SpaceTeam/STS1_PCB_SIDEPANEL/Muster/STS1_PCB_LIBRARIES/SpaceteamLib/spaceteam.models/Tantalum Capacitor Vishay/595D_A-case.pdf

THE INFORMATION AND/OR MATERIAL IN THIS DOCUMENT IS THE PROPERTY OF AND RESTRICTED INFORMATION AND/OR MATERIAL OF THE AUTHOR. THIS INFORMATION MAY NOT BE
USED, REPRODUCED, PUBLISHED OR DISCLOSED TO OTHERS WITHOUT WRITTEN AUTHORIZATION. IT IS TO BE USED ONLY FOR MANUFACTURING ITEMS SPECIFIED WITHIN THE DOCUMENT.
TITLE | 595D_A-case.stp PART NO | 595D_A-case REVISION | None DESIGNER | SAkselrod ENGINEER NOTES | v1.0
