SpaceTeam/STS1_PCB_SIDEPANEL/Muster/3G30A_40x80.png

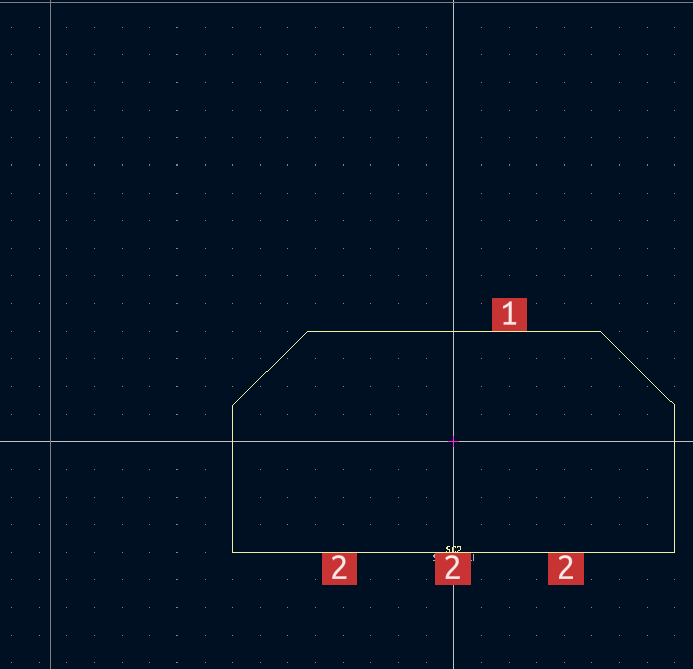
Muster/3G30A_40x80.png
