SpaceTeam/STS1_PCB_SIDEPANEL/STS1_Dhruva_Phase_2_Repaired/BOM_STS1_Sidepanels.xlsx

Sheet: X+
ID | Bezeichner | Footprint | Count | Bezeichnung
1 | RD2,RD1,RD3 | R_MiniMELF_MMA-0204 | 3 | 22R
2 | C41,C42 | C_0805_2012Metric | 2 | 22u 10V
3 | C11,C12,C61,C62 | C_0805_2012Metric | 4 | 22u 6.3V
4 | TH1 | R_0805_2012Metric_Pad1.20x1.40mm_HandSolder | 1 | Thermistor_NTC
5 | J3 | M808280442 | 1 | Conn_02x02_Odd_Even
6 | D21,D22 | DIO_SMM4F5.0A-TR | 2 | SMM4F5.0
7 | MPPT1,MPPT2 | TSSOP-8_4.4x3mm_P0.65mm | 2 | SPV1040TTR
8 | R21,R22,R31,R32,R41,R42,R71,R72 | R_0603_1608Metric | 8 | 1k
9 | D11,D12 | D_SOD-123F | 2 | PMEG2020EH
10 | R61,R62 | R_0603_1608Metric | 2 | 3k
11 | R11,R12 | R_0805_2012Metric | 2 | 10m
12 | U11,U12 | SOT-23-5 | 2 | INA180A4
13 | R51,R52 | R_0805_2012Metric | 2 | 220m
14 | C21,C22,C31,C32 | C_0603_1608Metric | 4 | 1n
15 | C51,C52 | C_0603_1608Metric | 2 | 1u
16 | J1 | SAMTEC_ZF5S-08-01-T-WT | 1 | Conn_01x10
17 | L_IN2,L1 | IND_XAL6060-103MEC | 2 | 10u

Sheet: Y-
ID | Bezeichner | Footprint | Count | Bezeichnung
1 | U1 | OLGA | 1 | GUVA-C32SM
2 | J1 | SAMTEC_ZF5S-08-01-T-WT | 1 | Conn_01x08
3 | C21,C22,C31,C32 | C_0603_1608Metric | 4 | 1n
4 | L1,L2 | IND_XAL6060-103MEC | 2 | 10u
5 | C41,C42 | C_0805_2012Metric | 2 | 22u 10V
6 | C11,C12,C61,C62 | C_0805_2012Metric | 4 | 22u 6.3V
7 | RU1,RU2 | R_0603_1608Metric | 2 | 4k7
8 | D11,D12 | D_SOD-123F | 2 | PMEG2020EH
9 | MPPT1,MPPT2 | TSSOP-8_4.4x3mm_P0.65mm | 2 | SPV1040TTR
10 | UV1 | 200528-0040 | 1 | 501461-0491
11 | R61,R62 | R_0603_1608Metric | 2 | 3k
12 | R21,R22,R31,R32,R41,R42,R71,R72 | R_0603_1608Metric | 8 | 1k
13 | D21,D22 | DIO_SMM4F5.0A-TR | 2 | SMM4F5.0
14 | U11,U12 | SOT-23-5 | 2 | INA180A4
15 | C1,C51,C52 | C_0603_1608Metric | 3 | 1u
16 | R11,R12 | R_0805_2012Metric | 2 | 10m
17 | R51,R52 | R_0805_2012Metric | 2 | 220m
18 | TH1 | R_0805_2012Metric_Pad1.20x1.40mm_HandSolder | 1 | Thermistor_NTC
19 | IC1 | SOT-563 | 1 | TMP112AQDRLRQ1

Sheet: Y+
ID | Bezeichner | Footprint | Count | Bezeichnung
1 | U1 | OLGA | 1 | GUVA-C32SM
2 | J1 | SAMTEC_ZF5S-08-01-T-WT | 1 | Conn_01x08
3 | C21,C22,C31,C32 | C_0603_1608Metric | 4 | 1n
4 | L1,L2 | IND_XAL6060-103MEC | 2 | 10u
5 | C41,C42 | C_0805_2012Metric | 2 | 22u 10V
6 | C11,C12,C61,C62 | C_0805_2012Metric | 4 | 22u 6.3V
6 | RU1,RU2 | R_0603_1608Metric | 2 | 4k7
7 | D11,D12 | D_SOD-123F | 2 | PMEG2020EH
8 | MPPT1,MPPT2 | TSSOP-8_4.4x3mm_P0.65mm | 2 | SPV1040TTR
9 | UV1 | 200528-0040 | 1 | 501461-0491
10 | R61,R62 | R_0603_1608Metric | 2 | 3k
11 | R21,R22,R31,R32,R41,R42,R71,R72 | R_0603_1608Metric | 8 | 1k
12 | D21,D22 | DIO_SMM4F5.0A-TR | 2 | SMM4F5.0
13 | U11,U12 | SOT-23-5 | 2 | INA180A4
14 | C1,C51,C52 | C_0603_1608Metric | 3 | 1u
15 | R11,R12 | R_0805_2012Metric | 2 | 10m
16 | R51,R52 | R_0805_2012Metric | 2 | 220m
17 | TH1 | R_0805_2012Metric_Pad1.20x1.40mm_HandSolder | 1 | Thermistor_NTC
18 | IC1 | SOT-563 | 1 | TMP112AQDRLRQ1

Sheet: Z-
ID | Bezeichner | Footprint | Count | Bezeichnung
1 | U1 | OLGA | 1 | GUVA-C32SM
2 | edu_con1,cam1 | 545482271 | 2 | 54548-2271
3 | R21,R31,R41,R71 | R_0603_1608Metric | 4 | 1k
4 | TH1 | R_0805_2012Metric_Pad1.20x1.40mm_HandSolder | 1 | Thermistor_NTC
5 | UV1 | 200528-0040 | 1 | 501461-0491
6 | C1,C51 | C_0603_1608Metric | 2 | 1u
7 | IC1 | SOT-563 | 1 | TMP112AQDRLRQ1
8 | C41 | C_0805_2012Metric | 1 | 22u 10V
9 | C11,C61 | C_0805_2012Metric | 2 | 22u 6.3V
10 | RU1,RU2 | R_0603_1608Metric | 2 | 4k7
11 | D21 | DIO_SMM4F5.0A-TR | 1 | SMM4F5.0
12 | L1 | IND_XAL6060-103MEC | 1 | 10u
13 | J1 | SAMTEC_ZF5S-16-01-T-WT | 1 | Conn_01x18
14 | U11 | SOT-23-5 | 1 | INA180A4
15 | R61 | R_0603_1608Metric | 1 | 3k
16 | C21,C31 | C_0603_1608Metric | 2 | 1n
17 | MPPT1 | TSSOP-8_4.4x3mm_P0.65mm | 1 | SPV1040TTR
18 | R51 | R_0805_2012Metric | 1 | 220m
19 | D11 | D_SOD-123F | 1 | PMEG2020EH
20 | R11 | R_0805_2012Metric | 1 | 10m

Sheet: Z+
ID | Bezeichner | Footprint | Count | Bezeichnung
1 | U1 | OLGA | 1 | GUVA-C32SM
2 | C1,C51 | C_0603_1608Metric | 2 | 1u
3 | IC1 | SOT-563 | 1 | TMP112AQDRLRQ1
4 | C21,C31 | C_0603_1608Metric | 2 | 1n
5 | MPPT1 | TSSOP-8_4.4x3mm_P0.65mm | 1 | SPV1040TTR
6 | D21 | DIO_SMM4F5.0A-TR | 1 | SMM4F5.0
7 | R51 | R_0805_2012Metric | 1 | 220m
8 | R61 | R_0603_1608Metric | 1 | 3k
9 | R21,R31,R41,R71 | R_0603_1608Metric | 4 | 1k
10 | L1 | IND_XAL6060-103MEC | 1 | 10u
11 | RU1,RU2 | R_0603_1608Metric | 2 | 4k7
12 | R11 | R_0805_2012Metric | 1 | 10m
13 | J1 | SAMTEC_ZF5S-08-01-T-WT | 1 | Conn_01x08
14 | edu_con2,cam2 | 545482271 | 2 | 54548-2271
15 | UV1 | 200528-0040 | 1 | 501461-0491
16 | C41 | C_0805_2012Metric | 1 | 22u 10V
17 | C11,C61 | C_0805_2012Metric | 2 | 22u 6.3V
18 | TH1 | R_0805_2012Metric_Pad1.20x1.40mm_HandSolder | 1 | Thermistor_NTC
19 | U11 | SOT-23-5 | 1 | INA180A4
20 | D11 | D_SOD-123F | 1 | PMEG2020EH
