SpaceTeam/STS1_PCB_SIDEPANEL/Muster/STS1_PCB_LIBRARIES/Parts/小功率封装.dxf

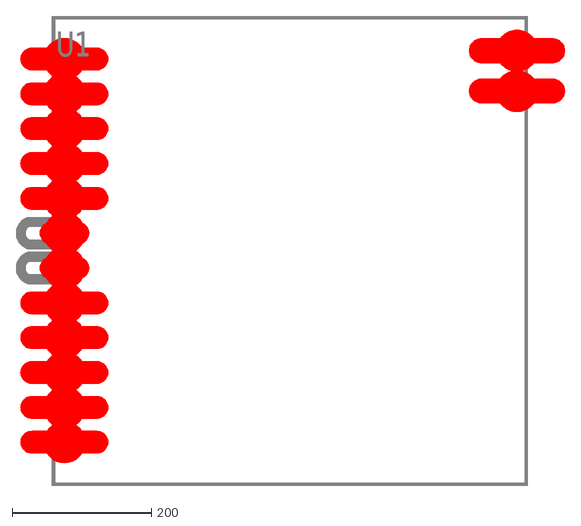
[picture p2: CAD file, 2022-07-06]
Muster/STS1_PCB_LIBRARIES/Parts/小功率封装.dxf
U1
