SpaceTeam/STS1_PCB_SIDEPANEL/Muster/STS1_PCB_LIBRARIES/SpaceteamLib/spaceteam.models/Tantalum Capacitor Vishay/595D_R-case.stp

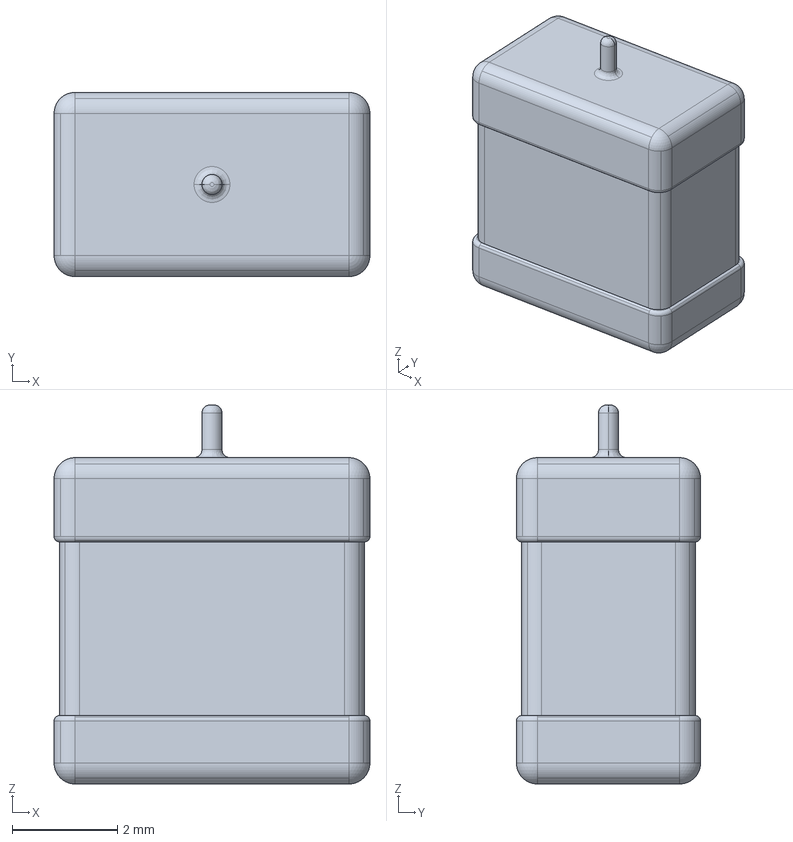
[picture p4: CAD file, 2022-07-06]
Muster/STS1_PCB_LIBRARIES/SpaceteamLib/spaceteam.models/Tantalum Capacitor Vishay/595D_R-case.stp
6.00 x 3.50 x 7.20 mm
