SpaceTeam/STS1_PCB_SIDEPANEL/Muster/STS1_PCB_LIBRARIES/SpaceteamLib/spaceteam.models/Wuerth_Inductor/WE-HCI_1335_744313 (rev1).stp

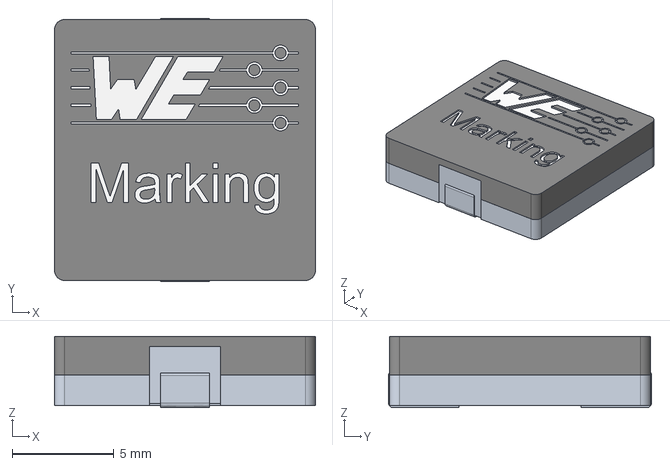
[picture p5: CAD file, 2022-07-06]
Muster/STS1_PCB_LIBRARIES/SpaceteamLib/spaceteam.models/Wuerth_Inductor/WE-HCI_1335_744313 (rev1).stp
12.8 x 12.9 x 3.50 mm
