SpaceTeam/STS1_PCB_SIDEPANEL/Muster/STS1_PCB_LIBRARIES/SpaceteamLib/spaceteam.models/Tantalum Capacitor Vishay/R-Case.FCStd

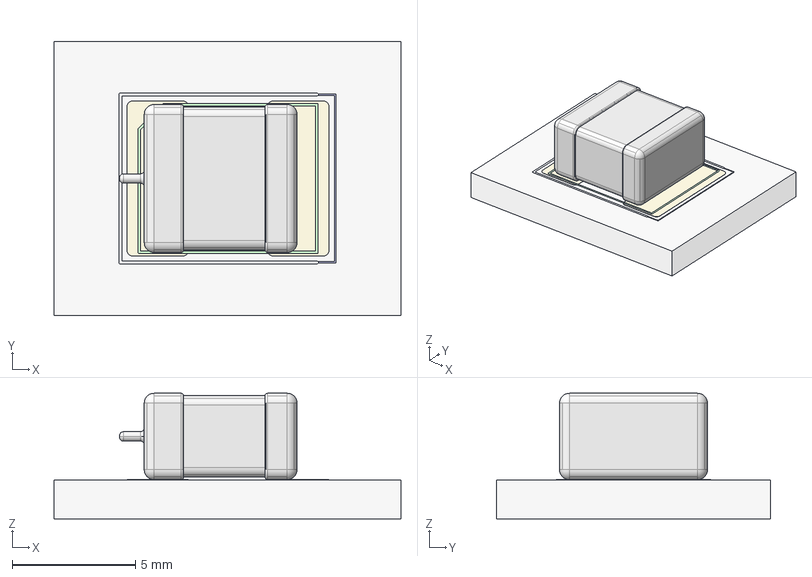
[picture p7: CAD file, 2022-07-06]
Muster/STS1_PCB_LIBRARIES/SpaceteamLib/spaceteam.models/Tantalum Capacitor Vishay/R-Case.FCStd
14.1 x 11.1 x 5.09 mm
FCrtYd
FFab
FrontSilk
TopPads
Pcb
595D_R-CASE
