SpaceTeam/STS1_PCB_SIDEPANEL/Muster/STS1_PCB_LIBRARIES/SpaceteamLib/spaceteam.models/Tantalum Capacitor Vishay/595D_D-case.stp

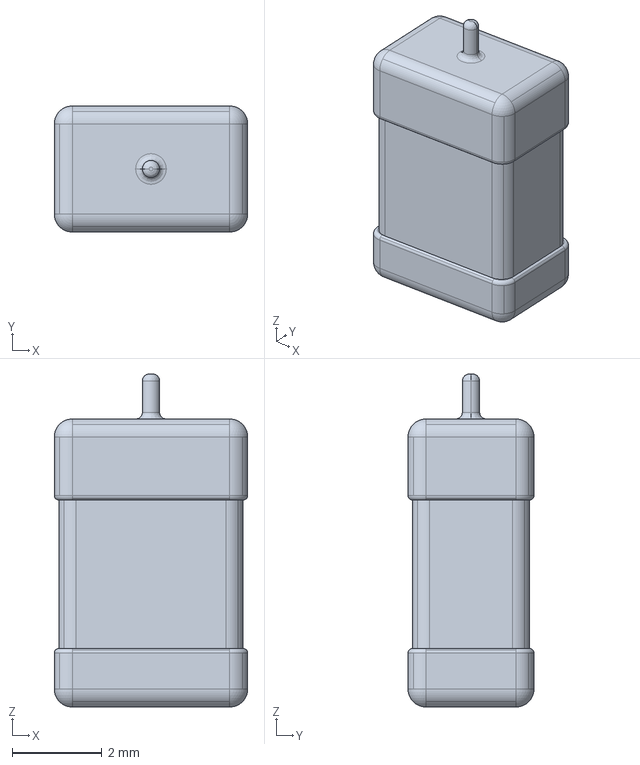
[picture p9: CAD file, 2022-07-06]
Muster/STS1_PCB_LIBRARIES/SpaceteamLib/spaceteam.models/Tantalum Capacitor Vishay/595D_D-case.stp
4.30 x 2.80 x 7.40 mm
