SpaceTeam/STS1_PCB_SIDEPANEL/Muster/STS1_PCB_LIBRARIES/SpaceteamLib/spaceteam.models/DG308-2.54-xxP (pitch 2.54mm)/DG308-2.54-06P-14-00AH.STEP

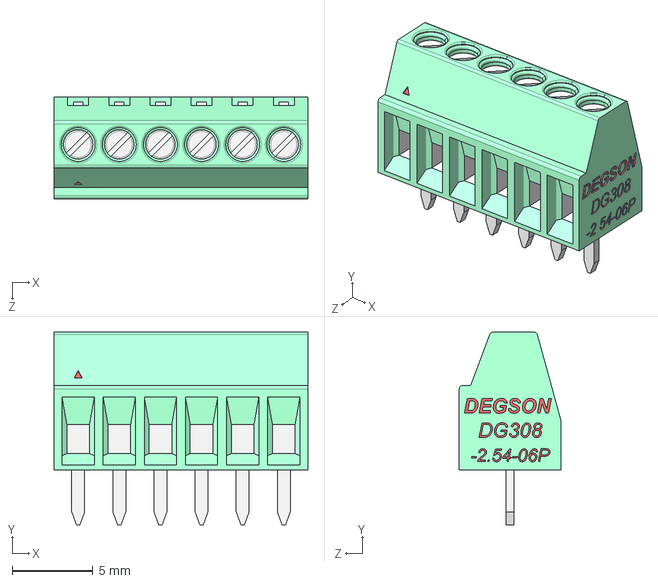
[picture p10: CAD file, 2022-07-06]
Muster/STS1_PCB_LIBRARIES/SpaceteamLib/spaceteam.models/DG308-2.54-xxP (pitch 2.54mm)/DG308-2.54-06P-14-00AH.STEP
15.7 x 11.9 x 6.27 mm
