SpaceTeam/STS1_PCB_SIDEPANEL/Muster/STS1_PCB_LIBRARIES/SpaceteamLib/spaceteam.models/Tantalum Capacitor Vishay/595D_C-case.stp

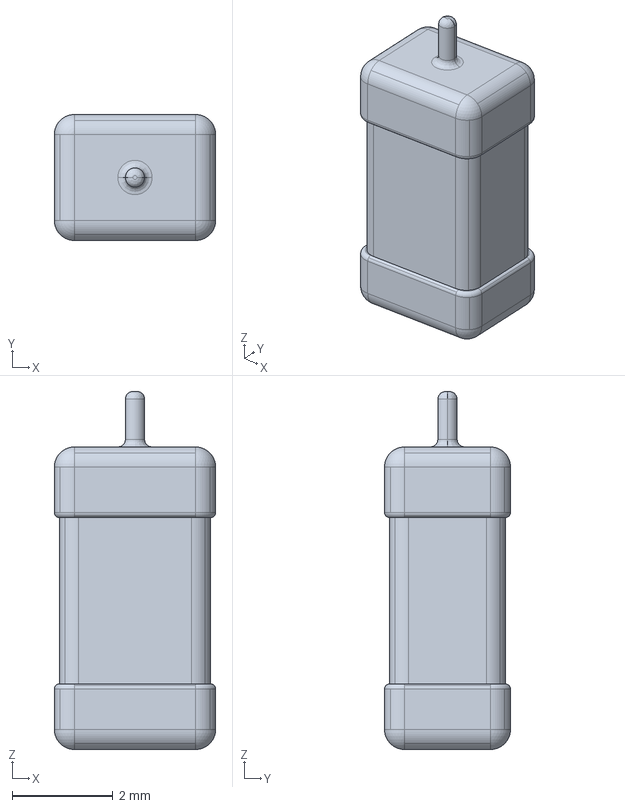
[picture p11: CAD file, 2022-07-06]
Muster/STS1_PCB_LIBRARIES/SpaceteamLib/spaceteam.models/Tantalum Capacitor Vishay/595D_C-case.stp
3.20 x 2.50 x 7.10 mm
