SpaceTeam/STS1_PCB_SIDEPANEL/Muster/STS1_PCB_LIBRARIES/Parts/F27 F30  package 2018.dxf

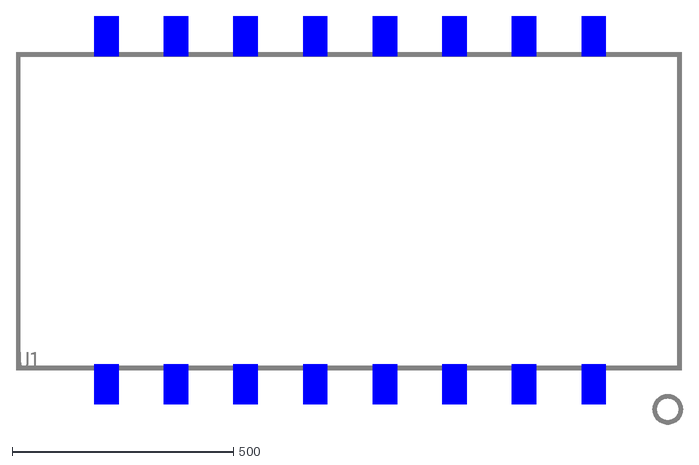
[picture p12: CAD file, 2022-07-06]
Muster/STS1_PCB_LIBRARIES/Parts/F27 F30 package 2018.dxf
U1
