SpaceTeam/STS1_PCB_SIDEPANEL/(list of files, cad)

Other CAD files:
Muster/STS1_PCB_LIBRARIES/Parts/si4463_Vc2/master/master.obj
Muster/STS1_PCB_LIBRARIES/Parts/si4463_Vc2/slaver/startup.obj
Muster/STS1_PCB_LIBRARIES/Parts/si4463_Vc2/master/startup.obj
Muster/STS1_PCB_LIBRARIES/Parts/si4463_Vc2/slaver/slaver.obj
Muster/STS1_PCB_LIBRARIES/SpaceteamLib/spaceteam.models/Tantalum Capacitor Vishay/595D_R-case-corrected.stp
Muster/STS1_PCB_LIBRARIES/Parts/si4463_Vc2/master/master(1).obj
Muster/STS1_PCB_LIBRARIES/Parts/si4463_Vc2/master/startup(1).obj
Muster/STS1_PCB_LIBRARIES/Parts/si4463_Vc2/slaver/slaver(1).obj
Muster/STS1_PCB_LIBRARIES/Parts/si4463_Vc2/slaver/startup(1).obj
Muster/STS1_PCB_LIBRARIES/SpaceteamLib/spaceteam.models/MAX16990ATCE_V_.step
Muster/STS1_PCB_LIBRARIES/SpaceteamLib/spaceteam.models/Maxim_Electronics_-_MAX25239AFOA/MAX25239_MAX25240.step
