SpaceTeam/STS1_PCB_SIDEPANEL/(threads)

Thread 20 (2024-05-06):

Remove Ground loops

dergaliator, 2024-05-06:
EDU Flex PCB Connectors and EPS Flex PCB Connector generate a ground loop.

Closed 2024-08-11.
