SpaceTeam/STS1_PCB_SIDEPANEL/(list of files, drawings)

Other design files:
Muster/STS1_PCB_LIBRARIES/Parts/F27 F30 package 2018(1).pcb
Muster/STS1_PCB_LIBRARIES/Parts/F27 F30 package 2018(2).pcb
Muster/STS1_PCB_LIBRARIES/Parts/F27 F30 package 2018(3).pcb
Muster/STS1_PCB_LIBRARIES/Parts/F27 F30 package 2018.pcb
