SpaceTeam/STS1_PCB_SIDEPANEL/Sidepanel X+/STS1_SIDEPANEL.kicad_pcb

## KiCad design Sidepanel X+/STS1_SIDEPANEL.kicad_pcb (2026-10-17)

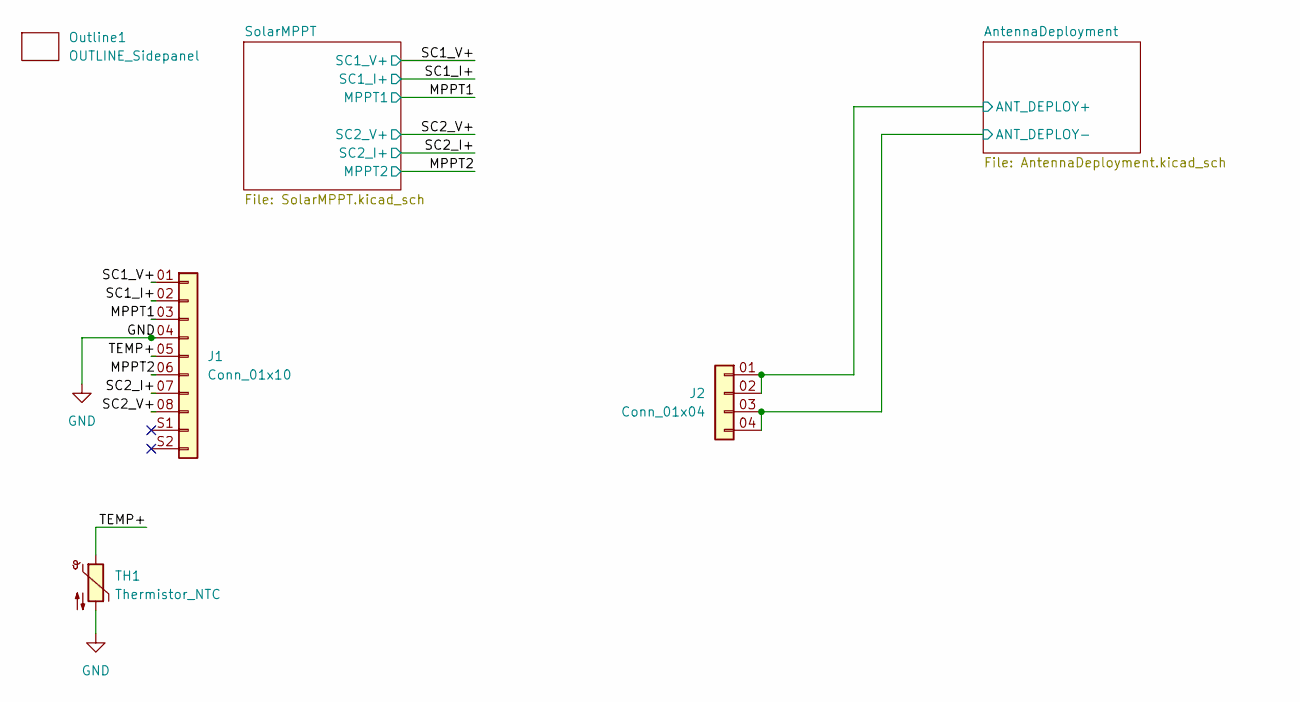
[picture p22: schematic STS1_SIDEPANEL.kicad_sch]

Parts:
J1: Conn_01x10; SAMTEC_T1M-08-F-SH-L
J2: Conn_01x04; SAMTEC_T1M-04-X-SV-L
Outline1: OUTLINE_Sidepanel; OUTLINE_SidepanelX+
TH1: Thermistor_NTC; R_0805_2012Metric_Pad1.20x1.40mm_HandSolder

Connections:
/AntennaDeployment/ANT_DEPLOY+: J2.01 (Pin_1), J2.02 (Pin_2); also elsewhere on the board
/AntennaDeployment/ANT_DEPLOY-: J2.03 (Pin_3), J2.04 (Pin_4); also elsewhere on the board
/MPPT1: J1.03 (Pin_3); also elsewhere on the board
/MPPT2: J1.06 (Pin_6); also elsewhere on the board
/SC1_I+: J1.02 (Pin_2); also elsewhere on the board
/SC1_V+: J1.01 (Pin_1); also elsewhere on the board
/SC2_I+: J1.07 (Pin_7); also elsewhere on the board
/SC2_V+: J1.08 (Pin_8); also elsewhere on the board
/TEMP+: J1.05 (Pin_5), TH1.1
GND: J1.04 (Pin_4), TH1.2; also elsewhere on the board

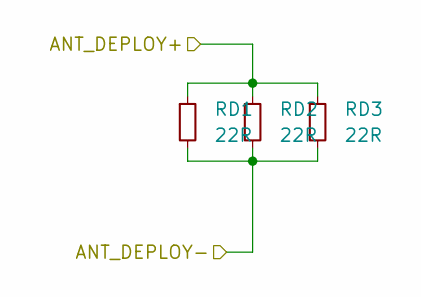
[picture p23: schematic AntennaDeployment.kicad_sch]

Parts:
RD1, RD2, RD3: 22R; R_MiniMELF_MMA-0204

Connections:
/AntennaDeployment/ANT_DEPLOY+: RD1.1, RD2.1, RD3.1; also elsewhere on the board
/AntennaDeployment/ANT_DEPLOY-: RD1.2, RD2.2, RD3.2; also elsewhere on the board

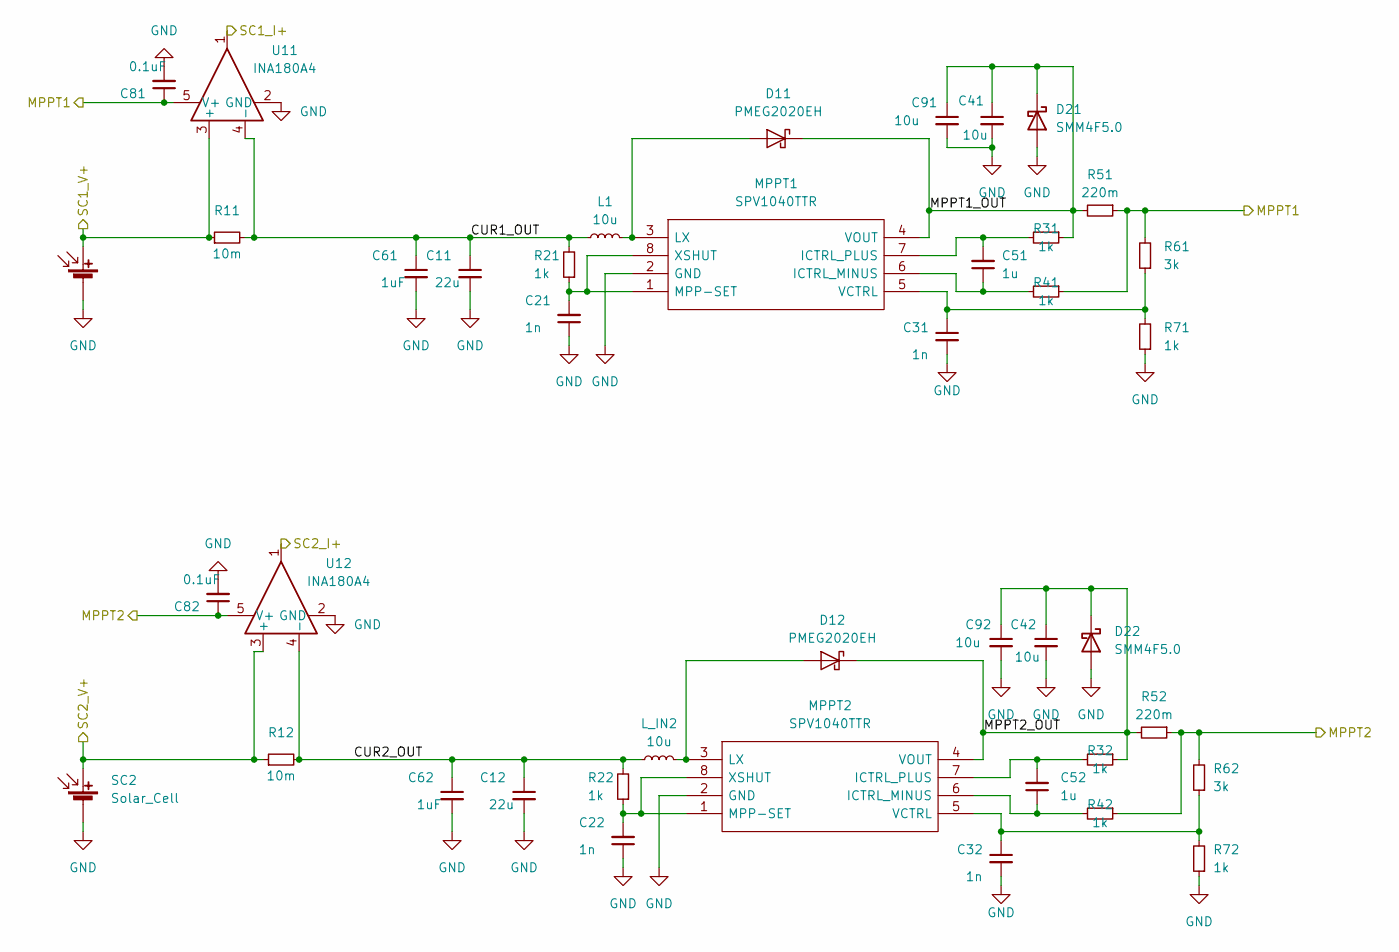
[picture p24: schematic SolarMPPT.kicad_sch]

Parts:
C11, C12: 22u; C_0805_2012Metric
C21, C22, C31, C32: 1n; C_0603_1608Metric
C41, C42, C91, C92: 10u; C_0805_2012Metric
C51, C52: 1u; C_0603_1608Metric
C61, C62: 1uF; C_0805_2012Metric
C81, C82: 0.1uF; C_0603_1608Metric
D11, D12: PMEG2020EH; D_SOD-123F
D21, D22: SMM4F5.0; DIO_SMM4F5.0A-TR
L1: 10u; IND_XAL6060-103MEC
L_IN2: 10u; IND_XAL6060-103MEC
MPPT1, MPPT2: SPV1040TTR; TSSOP-8_4.4x3mm_P0.65mm; Mouser Part Number 511-SPV1040TTR
R11, R12: 10m; R_0805_2012Metric
R21, R22, R31, R32, R41, R42, R71, R72: 1k; R_0603_1608Metric
R51, R52: 220m; R_0805_2012Metric
R61, R62: 3k; R_0603_1608Metric
SC1: Solar_Cell; 3G30A_40x80_Z_SC1
SC2: Solar_Cell; 3G30A_40x80_Z_SC2
U11, U12: INA180A4; SOT-23-5

Connections:
/MPPT1: C81.1, R41.1, R51.1, R61.2, U11.5 (V+); also elsewhere on the board
/MPPT2: C82.1, R42.1, R52.1, R62.2, U12.5 (V+); also elsewhere on the board
/SC1_I+: U11.1; also elsewhere on the board
/SC1_V+: R11.1, SC1.1 (+), U11.3 (+); also elsewhere on the board
/SC2_I+: U12.1; also elsewhere on the board
/SC2_V+: R12.1, SC2.1 (+), U12.3 (+); also elsewhere on the board
/SolarMPPT/CUR1_OUT: C11.1, C61.1, L1.1, R11.2, R21.2, U11.4 (-)
/SolarMPPT/CUR2_OUT: C12.1, C62.1, L_IN2.1, R12.2, R22.2, U12.4 (-)
/SolarMPPT/MPPT1_OUT: C41.1, C91.1, D11.1 (K), D21.1 (K), MPPT1.4 (VOUT), R31.1, R51.2
/SolarMPPT/MPPT2_OUT: C42.1, C92.1, D12.1 (K), D22.1 (K), MPPT2.4 (VOUT), R32.1, R52.2
GND: C11.2, C12.2, C21.1, C22.1, C31.2, C32.2, C41.2, C42.2, C61.2, C62.2, C81.2, C82.2, C91.2, C92.2, D21.2 (A), D22.2 (A), MPPT1.2 (GND), MPPT2.2 (GND), R71.1, R72.1, SC1.2 (-), SC2.2 (-), U11.2 (GND), U12.2 (GND); also elsewhere on the board
unnamed: D11.2 (A), L1.2, MPPT1.3 (LX)
unnamed: D12.2 (A), L_IN2.2, MPPT2.3 (LX)
unnamed: C51.1, MPPT1.6 (ICTRL_MINUS), R41.2
unnamed: C51.2, MPPT1.7 (ICTRL_PLUS), R31.2
unnamed: C21.2, MPPT1.1 (MPP-SET), MPPT1.8 (XSHUT), R21.1
unnamed: C31.1, MPPT1.5 (VCTRL), R61.1, R71.2
unnamed: C52.1, MPPT2.6 (ICTRL_MINUS), R42.2
unnamed: C52.2, MPPT2.7 (ICTRL_PLUS), R32.2
unnamed: C22.2, MPPT2.1 (MPP-SET), MPPT2.8 (XSHUT), R22.1
unnamed: C32.1, MPPT2.5 (VCTRL), R62.1, R72.2

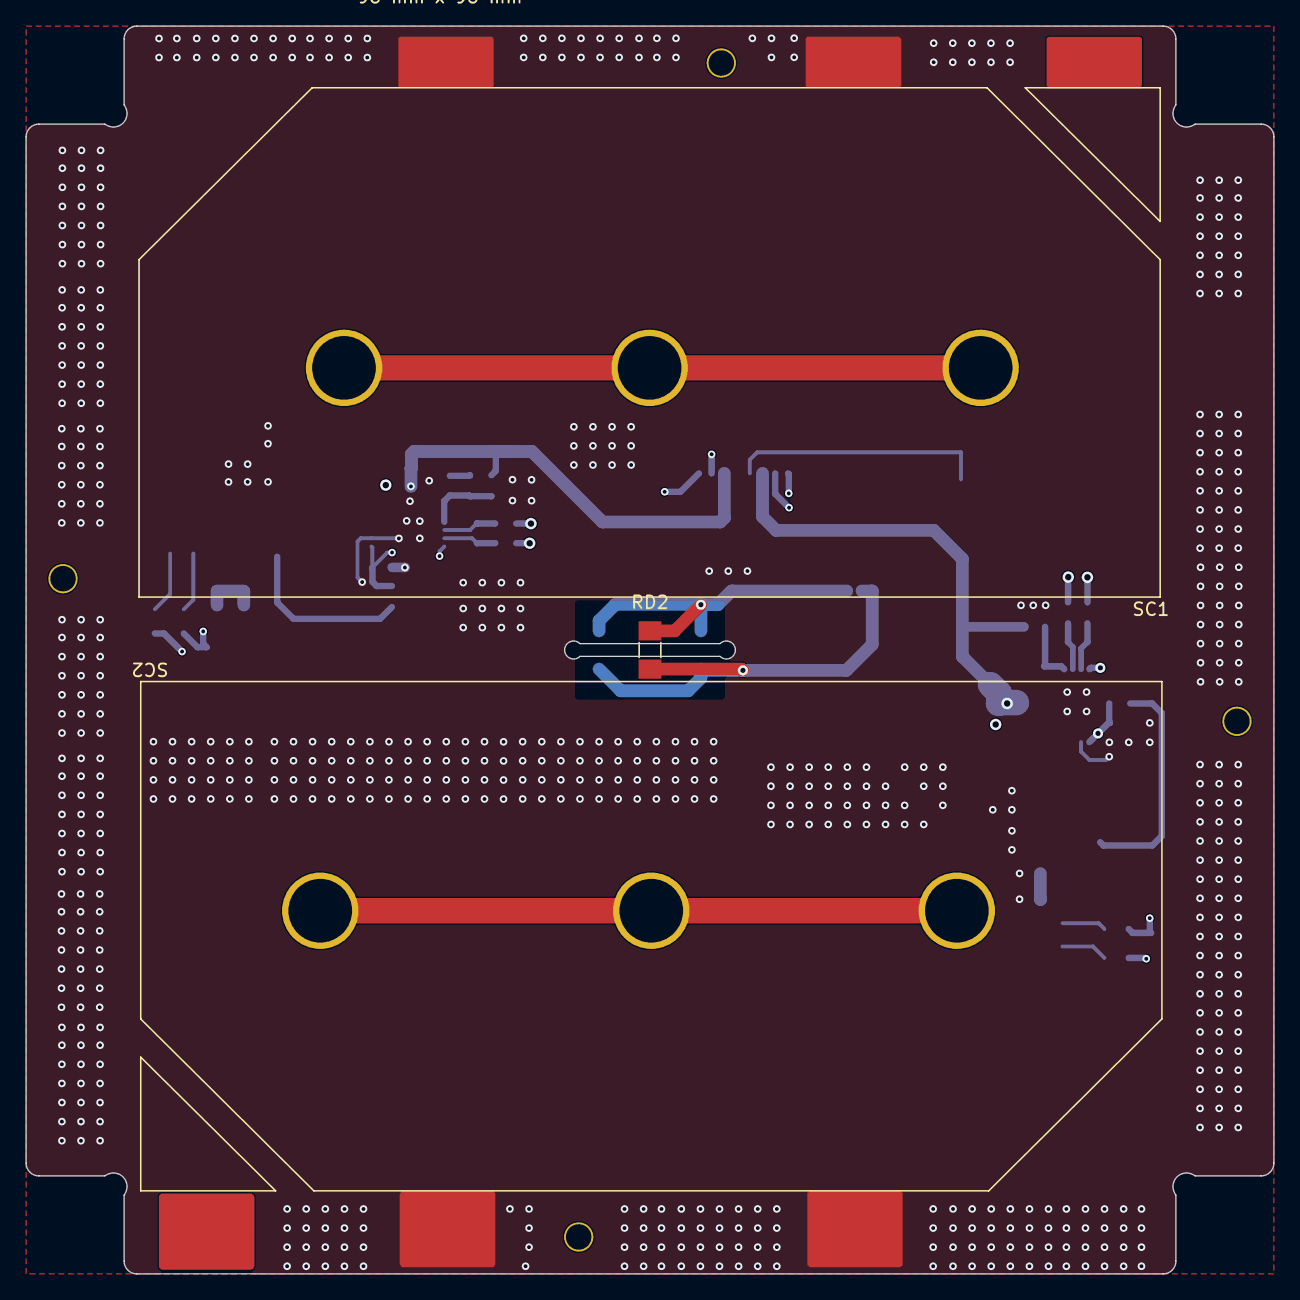
[picture p25: board Sidepanel X+/STS1_SIDEPANEL.kicad_pcb from above]

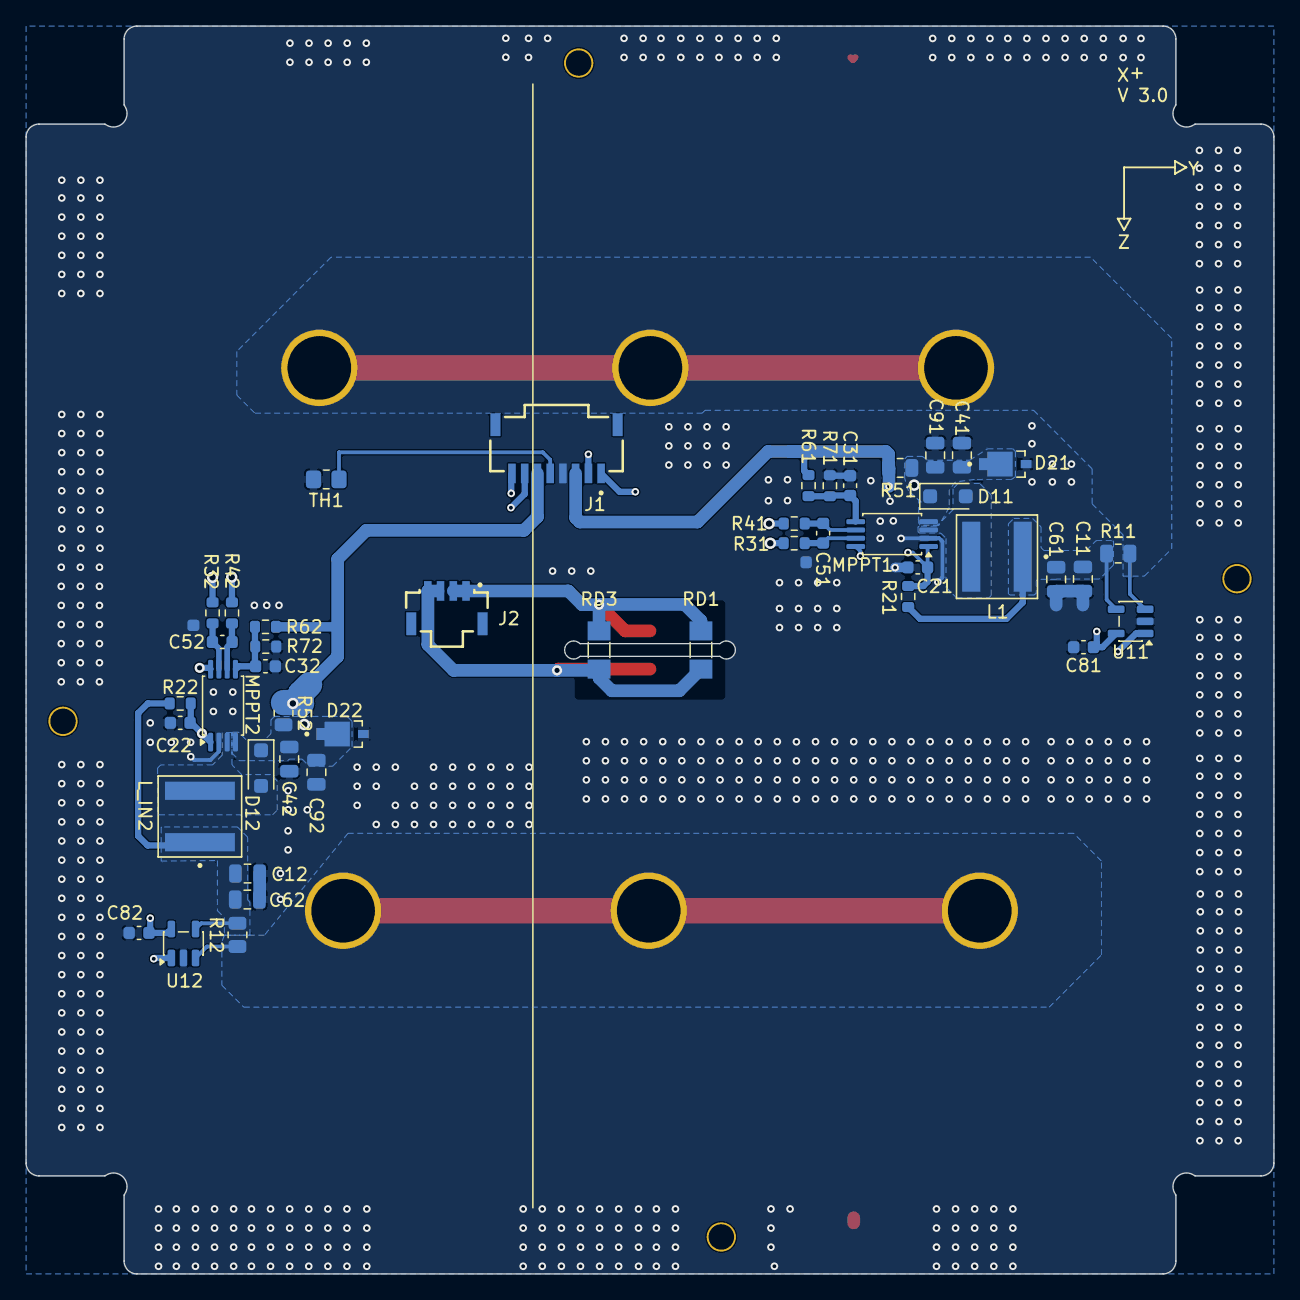
[picture p26: board Sidepanel X+/STS1_SIDEPANEL.kicad_pcb from below]

Board: 4 copper layers, 98.0 x 98.0 mm, 49 parts (45 on the bottom side), 24 nets.
