SpaceTeam/STS1_PCB_SIDEPANEL/Sidepanel Z-/STS1_SIDEPANEL.kicad_pcb

## KiCad design Sidepanel Z-/STS1_SIDEPANEL.kicad_pcb (2026-07-31)

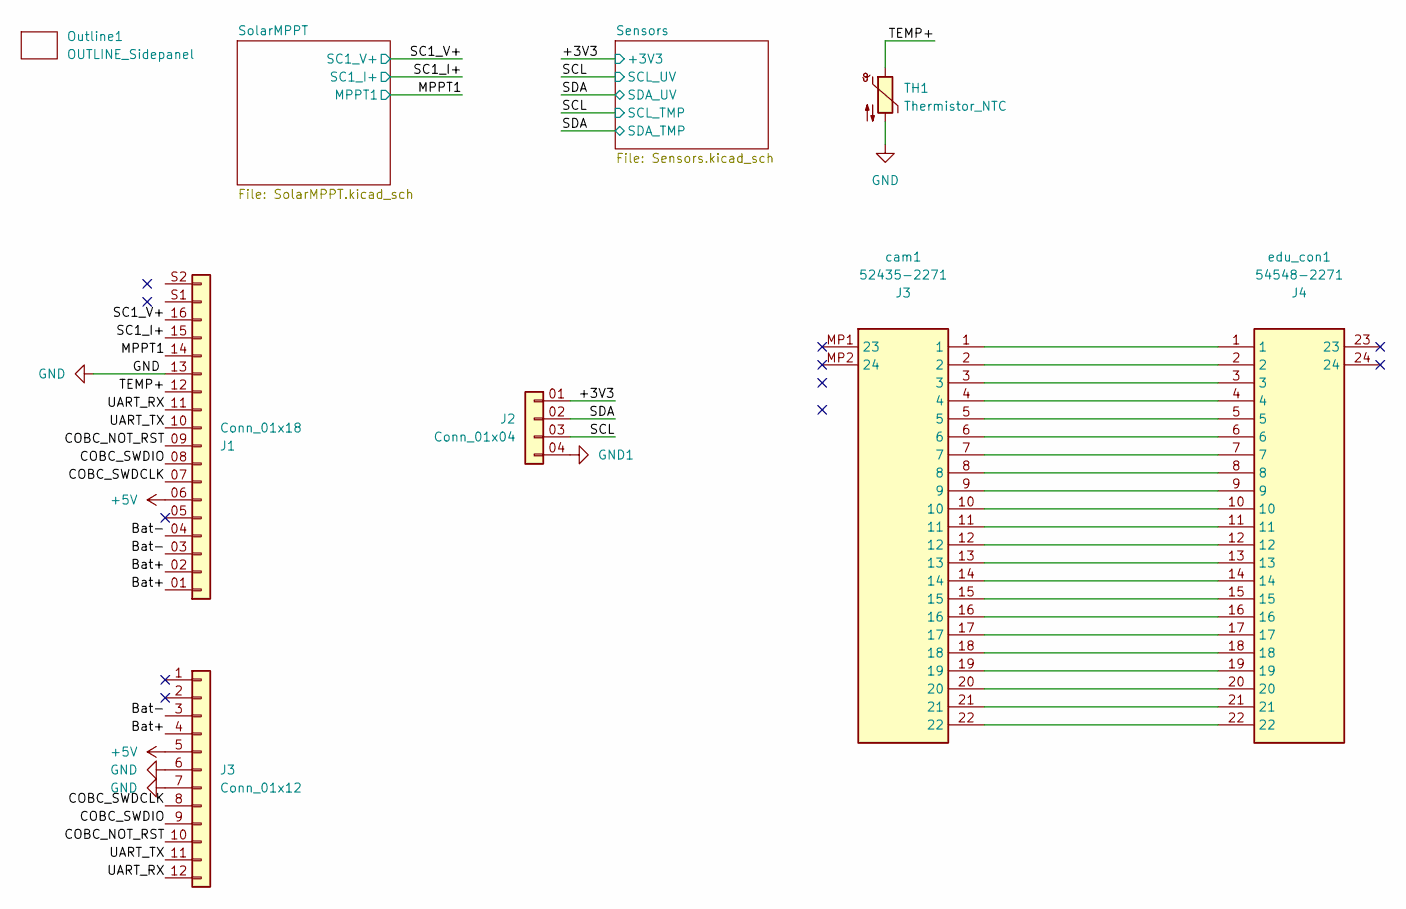
[picture p27: schematic STS1_SIDEPANEL.kicad_sch]

Parts:
J1: Conn_01x18; SAMTEC_T1M-16-F-SH-L
J2: Conn_01x04; SAMTEC_T1M-04-X-SH-L
J3: Conn_01x12; conn_to_panel
Outline1: OUTLINE_Sidepanel; OUTLINE_SidepanelZ-
TH1: Thermistor_NTC; R_0805_2012Metric_Pad1.20x1.40mm_HandSolder
cam1: 52435-2271; 524352271; Manufacturer_Part_Number 54548-2271; Mouser Part Number 538-54548-2271
edu_con1: 54548-2271; 545482271; Manufacturer_Part_Number 54548-2271; Mouser Part Number 538-54548-2271

Connections:
+5V: J1.06 (Pin_6), J3.5
/+3V3: J2.01 (Pin_1); also elsewhere on the board
/Bat+: J1.01 (Pin_1), J1.02 (Pin_2), J3.4
/Bat-: J1.03 (Pin_3), J1.04 (Pin_4), J3.3
/COBC_NOT_RST: J1.09 (Pin_9), J3.10
/COBC_SWDCLK: J1.07 (Pin_7), J3.8
/COBC_SWDIO: J1.08 (Pin_8), J3.9
/MPPT1: J1.14; also elsewhere on the board
/SC1_I+: J1.15; also elsewhere on the board
/SC1_V+: J1.16; also elsewhere on the board
/SCL: J2.03 (Pin_3); also elsewhere on the board
/SDA: J2.02 (Pin_2); also elsewhere on the board
/TEMP+: J1.12, TH1.1
/UART_RX: J1.11, J3.12
/UART_TX: J1.10, J3.11
GND: J1.13, J3.6, J3.7, TH1.2; also elsewhere on the board
GND1: J2.04 (Pin_4); also elsewhere on the board
unnamed: cam1.1, edu_con1.1
unnamed: cam1.2, edu_con1.2
unnamed: cam1.3, edu_con1.3
unnamed: cam1.4, edu_con1.4
unnamed: cam1.5, edu_con1.5
unnamed: cam1.6, edu_con1.6
unnamed: cam1.7, edu_con1.7
unnamed: cam1.8, edu_con1.8
unnamed: cam1.9, edu_con1.9
unnamed: cam1.10, edu_con1.10
unnamed: cam1.11, edu_con1.11
unnamed: cam1.12, edu_con1.12
unnamed: cam1.13, edu_con1.13
unnamed: cam1.14, edu_con1.14
unnamed: cam1.15, edu_con1.15
unnamed: cam1.16, edu_con1.16
unnamed: cam1.17, edu_con1.17
unnamed: cam1.18, edu_con1.18
unnamed: cam1.19, edu_con1.19
unnamed: cam1.20, edu_con1.20
unnamed: cam1.21, edu_con1.21
unnamed: cam1.22, edu_con1.22

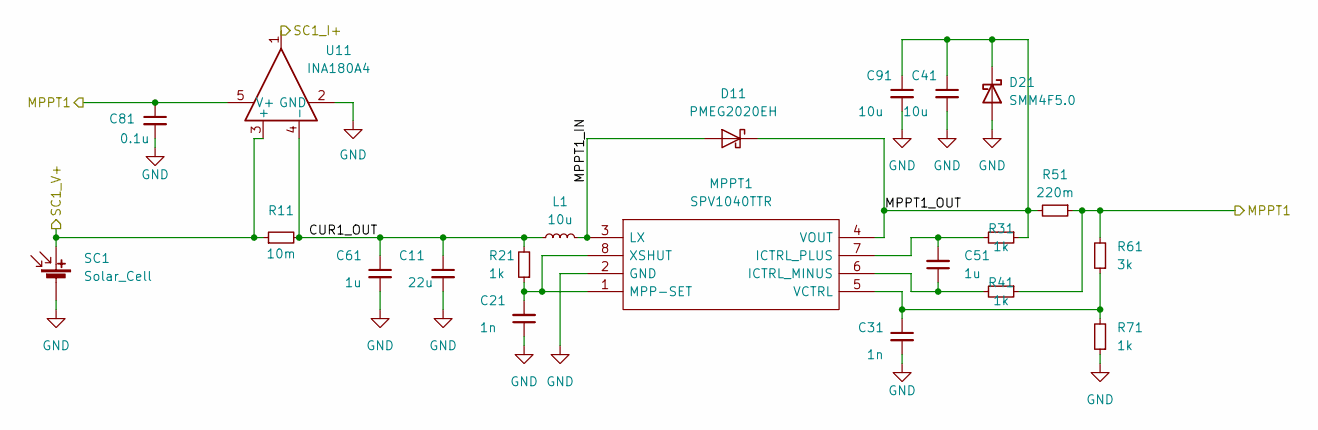
[picture p28: schematic SolarMPPT.kicad_sch]

Parts:
C11: 22u; C_0805_2012Metric
C21, C31: 1n; C_0603_1608Metric
C41, C91: 10u; C_0805_2012Metric
C51: 1u; C_0603_1608Metric
C61: 1u; C_0805_2012Metric
C81: 0.1u; C_0603_1608Metric
D11: PMEG2020EH; D_SOD-123F
D21: SMM4F5.0; DIO_SMM4F5.0A-TR
L1: 10u; IND_XAL6060-103MEC
MPPT1: SPV1040TTR; TSSOP-8_4.4x3mm_P0.65mm; Mouser Part Number 511-SPV1040TTR
R11: 10m; R_0805_2012Metric
R21, R31, R41, R71: 1k; R_0603_1608Metric
R51: 220m; R_0805_2012Metric
R61: 3k; R_0603_1608Metric
SC1: Solar_Cell; 3G30A_40x80
U11: INA180A4; SOT-23-5

Connections:
/MPPT1: C81.1, R41.1, R51.1, R61.2, U11.5 (V+); also elsewhere on the board
/SC1_I+: U11.1; also elsewhere on the board
/SC1_V+: R11.1, SC1.1 (+), U11.3 (+); also elsewhere on the board
/SolarMPPT/CUR1_OUT: C11.1, C61.1, L1.1, R11.2, R21.2, U11.4 (-)
/SolarMPPT/MPPT1_IN: D11.2 (A), L1.2, MPPT1.3 (LX)
/SolarMPPT/MPPT1_OUT: C41.1, C91.1, D11.1 (K), D21.1, MPPT1.4 (VOUT), R31.1, R51.2
GND: C11.2, C21.1, C31.2, C41.2, C61.2, C81.2, C91.2, D21.2, MPPT1.2 (GND), R71.1, SC1.2 (-), U11.2 (GND); also elsewhere on the board
unnamed: C51.1, MPPT1.6 (ICTRL_MINUS), R41.2
unnamed: C51.2, MPPT1.7 (ICTRL_PLUS), R31.2
unnamed: C21.2, MPPT1.1 (MPP-SET), MPPT1.8 (XSHUT), R21.1
unnamed: C31.1, MPPT1.5 (VCTRL), R61.1, R71.2

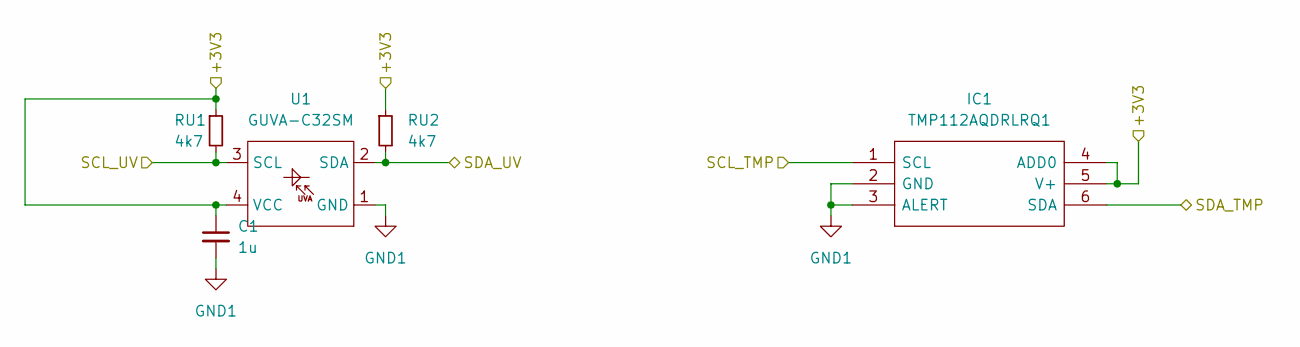
[picture p29: schematic Sensors.kicad_sch]

Parts:
C1: 1u; C_0603_1608Metric
IC1: TMP112AQDRLRQ1; SOT-563; Mouser Part Number 595-TMP112AQDRLRQ1
RU1, RU2: 4k7; R_0603_1608Metric
U1: GUVA-C32SM; OLGA

Connections:
/+3V3: C1.1, IC1.4 (ADD0), IC1.5 (V+), RU1.1, RU2.1, U1.4 (VCC); also elsewhere on the board
/SCL: IC1.1 (SCL), RU1.2, U1.3 (SCL); also elsewhere on the board
/SDA: IC1.6 (SDA), RU2.2, U1.2 (SDA); also elsewhere on the board
GND1: C1.2, IC1.2 (GND), IC1.3 (ALERT), U1.1 (GND); also elsewhere on the board

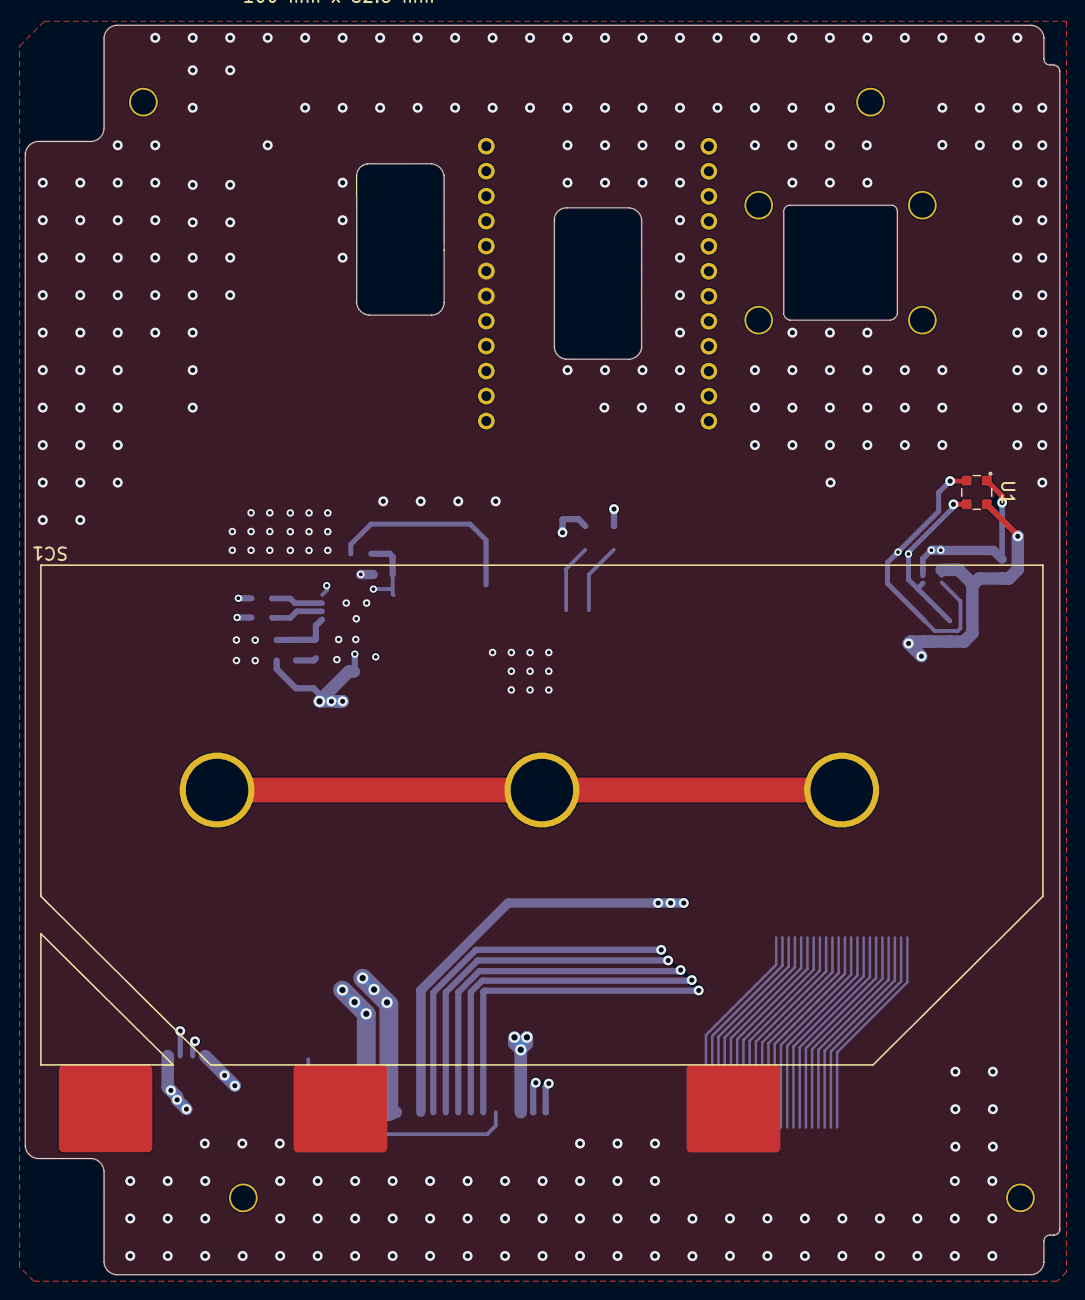
[picture p30: board Sidepanel Z-/STS1_SIDEPANEL.kicad_pcb from above]

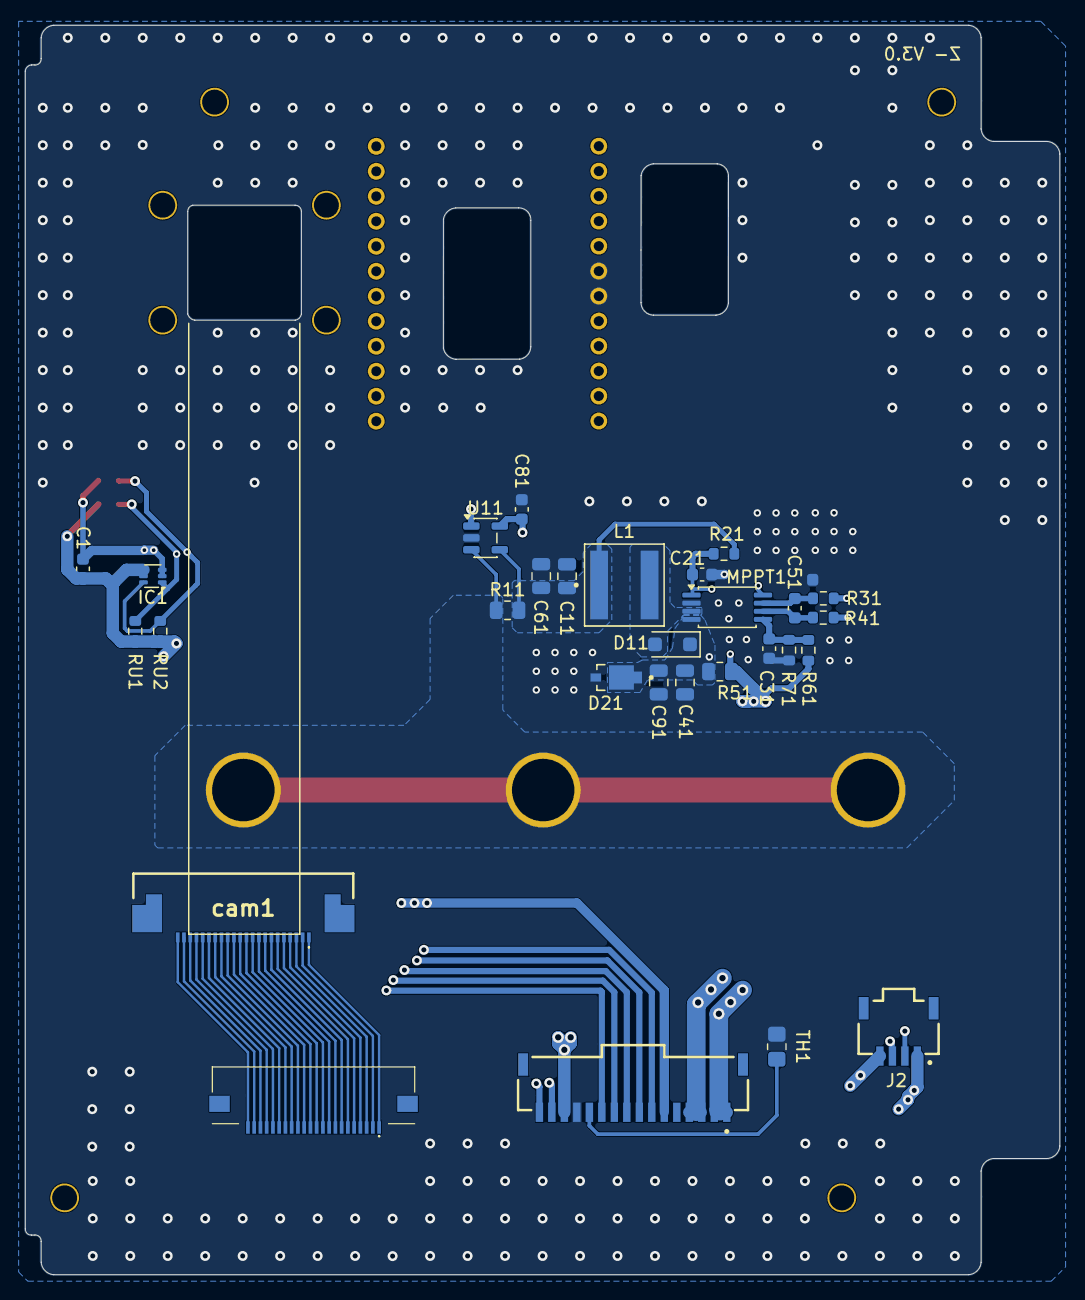
[picture p31: board Sidepanel Z-/STS1_SIDEPANEL.kicad_pcb from below]

Board: 4 copper layers, 82.8 x 100.0 mm, 34 parts (29 on the bottom side), 46 nets.

Other parts of the board:
uci_conn: conn_to_panel
