SpaceTeam/STS1_PCB_SIDEPANEL/UCI/UCI.kicad_pcb

## KiCad design UCI/UCI.kicad_pcb (2025-01-20)

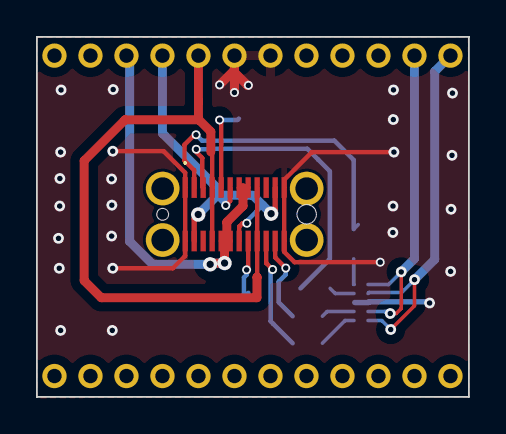
[picture p32: board UCI.kicad_pcb from above]

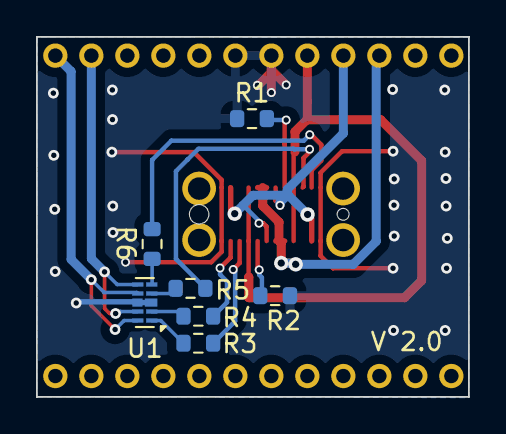
[picture p33: board UCI.kicad_pcb from below]

Board: 2 copper layers, 24.0 x 20.0 mm, 8 parts (7 on the bottom side), 16 nets.

Parts:
J1: USB_C_Receptacle; USB4160030170C
R1, R2: 5.11k; R_0603_1608Metric
R3, R4, R5, R6: 1k; R_0603_1608Metric
U1: ESD224DQA; Diodes_UDFN-10_1.0x2.5mm_P0.5mm

Connections:
1: J1.A2 (TX1+), R6.1
2: J1.A3 (TX1-), R5.1
3: J1.B3 (TX2-), R3.1
4: J1.B2 (TX2+), R4.1
+5V: J1.A4 (VBUS), J1.A9 (VBUS), J1.B4 (VBUS), J1.B9 (VBUS)
Bat+: J1.A6 (D+), J1.A11 (RX2+), J1.B6 (D+), J1.B11 (RX1+)
Bat-: J1.A7 (D-), J1.A8 (SBU1), J1.B7 (D-), J1.B8 (SBU2)
GND: J1.A1 (GND), J1.A12 (GND), J1.B1 (GND), J1.B12 (GND), R1.1, R2.1, U1.3 (VSS), U1.8 (VSS)
unnamed: J1.A5 (CC1), R1.2
unnamed: J1.B5 (CC2), R2.2
unnamed: R3.2, U1.1
unnamed: R4.2, U1.2
unnamed: R5.2, U1.4
unnamed: R6.2, U1.5
UCI_COBC_UART_RX: U1.7, U1.10
UCI_COBC_UART_TX: U1.6, U1.9
