SpaceTeam/STS1_PCB_SIDEPANEL/Muster/STS1_SIDEPANEL.kicad_pcb

## KiCad design Muster/STS1_SIDEPANEL.kicad_pcb (2023-07-27)

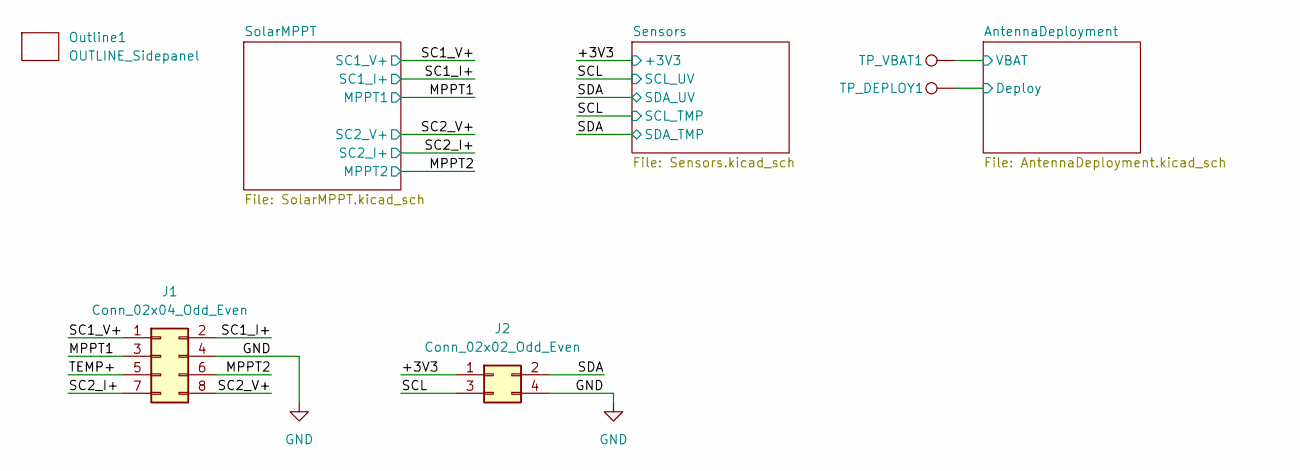
[picture p34: schematic STS1_SIDEPANEL.kicad_sch]

Parts:
J1: Conn_02x04_Odd_Even; M808280842
J2: Conn_02x02_Odd_Even; M80-8280442
Outline1: OUTLINE_Sidepanel; OUTLINE_SidepanelZ+
TP_DEPLOY1: TestPoint; TestPoint_Loop_D1.80mm_Drill1.0mm_Beaded
TP_VBAT1: TestPoint; TestPoint_Loop_D1.80mm_Drill1.0mm_Beaded

Connections:
/+3V3: J2.1; also elsewhere on the board
/AntennaDeployment/Deploy: TP_DEPLOY1.1; also elsewhere on the board
/AntennaDeployment/VBAT: TP_VBAT1.1; also elsewhere on the board
/MPPT1: J1.3; also elsewhere on the board
/MPPT2: J1.6; also elsewhere on the board
/SC1_I+: J1.2; also elsewhere on the board
/SC1_V+: J1.1; also elsewhere on the board
/SC2_I+: J1.7; also elsewhere on the board
/SC2_V+: J1.8; also elsewhere on the board
/SCL: J2.3; also elsewhere on the board
/SDA: J2.2; also elsewhere on the board
/TEMP+: J1.5
GND: J1.4, J2.4; also elsewhere on the board

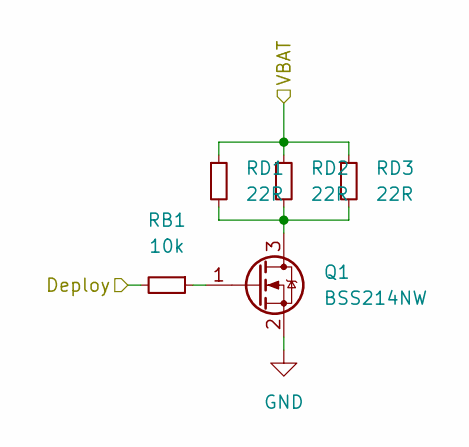
[picture p35: schematic AntennaDeployment.kicad_sch]

Parts:
Q1: BSS214NW; SOT-323_SC-70
RB1: 10k; R_0603_1608Metric
RD1, RD2, RD3: 22R; R_MiniMELF_MMA-0204

Connections:
/AntennaDeployment/Deploy: RB1.2; also elsewhere on the board
/AntennaDeployment/VBAT: RD1.1, RD2.1, RD3.1; also elsewhere on the board
GND: Q1.2 (S); also elsewhere on the board
unnamed: Q1.1 (G), RB1.1
unnamed: Q1.3 (D), RD1.2, RD2.2, RD3.2

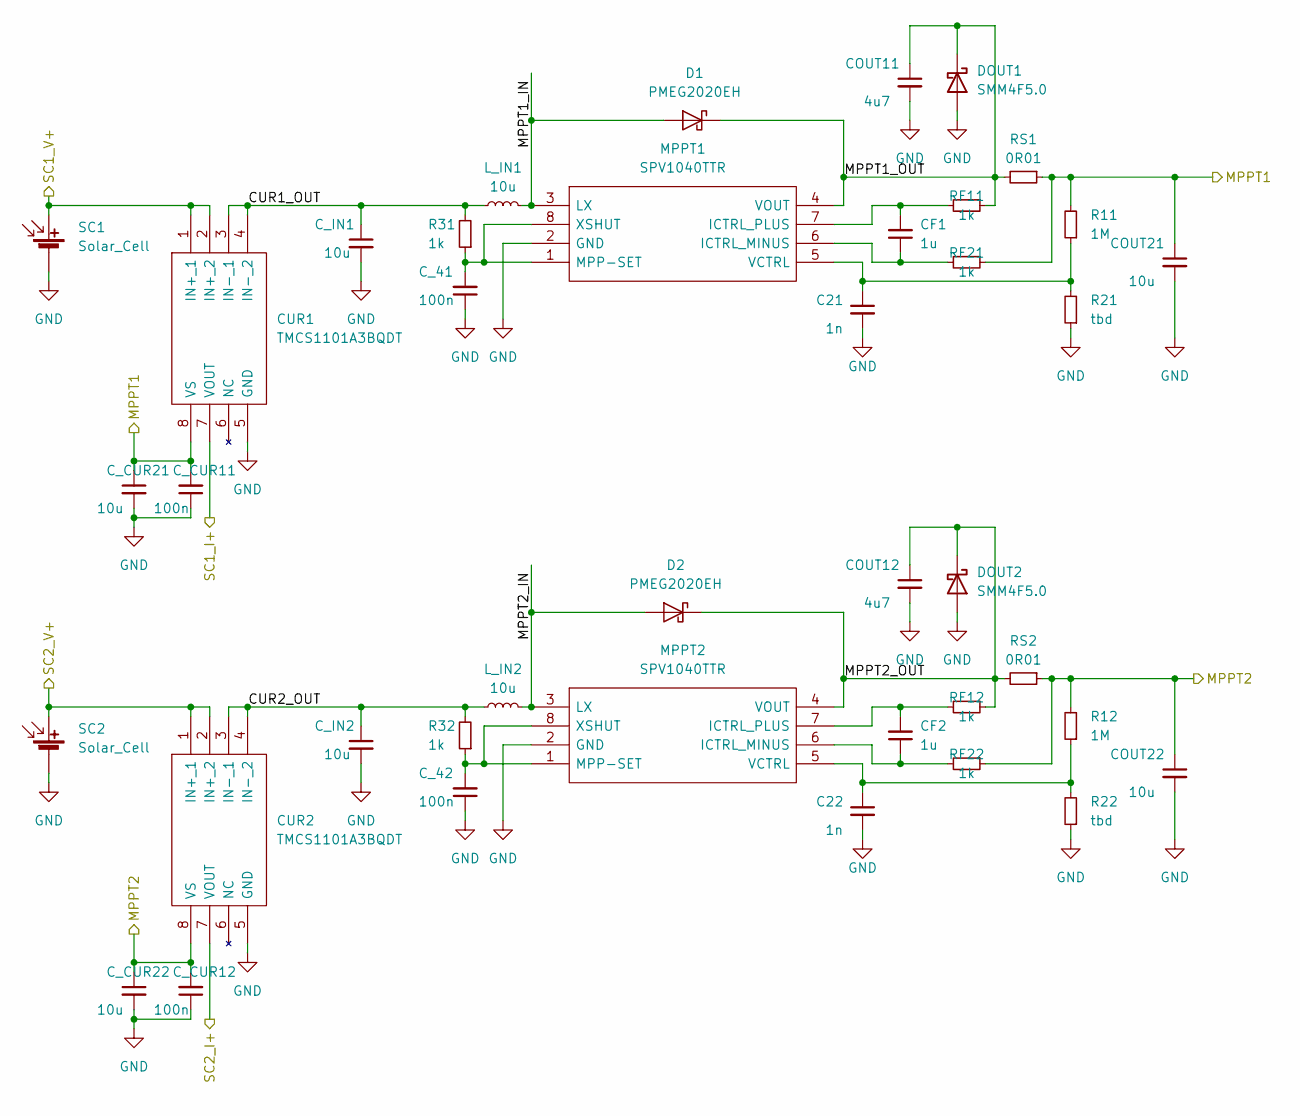
[picture p36: schematic SolarMPPT.kicad_sch]

Parts:
C21, C22: 1n; C_0603_1608Metric
CF1, CF2: 1u; C_0603_1608Metric
COUT11, COUT12: 4u7; C_0603_1608Metric
COUT21, COUT22: 10u; C_0603_1608Metric
CUR1, CUR2: TMCS1101A3BQDT; SOIC127P600X175-8N; Mouser Part Number 595-TMCS1101A3BQDT
C_41, C_42: 100n; C_0603_1608Metric
C_CUR11, C_CUR12: 100n; C_0603_1608Metric
C_CUR21, C_CUR22: 10u; C_0603_1608Metric
C_IN1, C_IN2: 10u; C_0603_1608Metric
D1, D2: PMEG2020EH; D_SOD-123F
DOUT1, DOUT2: SMM4F5.0; STMITE
L_IN1, L_IN2: 10u; INDPM5650X530N
MPPT1, MPPT2: SPV1040TTR; SOP65P640X120-8N; Mouser Part Number 511-SPV1040TTR
R11, R12: 1M; R_0603_1608Metric
R21, R22: tbd; R_0603_1608Metric
R31, R32: 1k; R_0603_1608Metric
RF11, RF12, RF21, RF22: 1k; R_0603_1608Metric
RS1, RS2: 0R01; R_0603_1608Metric
SC1, SC2: Solar_Cell; 3G30A_40x80

Connections:
/MPPT1: COUT21.1, CUR1.8 (VS), C_CUR11.2, C_CUR21.1, R11.2, RF21.1, RS1.1; also elsewhere on the board
/MPPT2: COUT22.1, CUR2.8 (VS), C_CUR12.2, C_CUR22.1, R12.2, RF22.1, RS2.1; also elsewhere on the board
/SC1_I+: CUR1.7 (VOUT); also elsewhere on the board
/SC1_V+: CUR1.1 (IN+_1), CUR1.2 (IN+_2), SC1.1 (+); also elsewhere on the board
/SC2_I+: CUR2.7 (VOUT); also elsewhere on the board
/SC2_V+: CUR2.1 (IN+_1), CUR2.2 (IN+_2), SC2.1 (+); also elsewhere on the board
/SolarMPPT/CUR1_OUT: CUR1.3 (IN-_1), CUR1.4 (IN-_2), C_IN1.1, L_IN1.1, R31.2
/SolarMPPT/CUR2_OUT: CUR2.3 (IN-_1), CUR2.4 (IN-_2), C_IN2.1, L_IN2.1, R32.2
/SolarMPPT/MPPT1_IN: D1.2 (A), L_IN1.2, MPPT1.3 (LX)
/SolarMPPT/MPPT1_OUT: COUT11.1, D1.1 (K), DOUT1.1 (K), MPPT1.4 (VOUT), RF11.1, RS1.2
/SolarMPPT/MPPT2_IN: D2.2 (A), L_IN2.2, MPPT2.3 (LX)
/SolarMPPT/MPPT2_OUT: COUT12.1, D2.1 (K), DOUT2.1 (K), MPPT2.4 (VOUT), RF12.1, RS2.2
GND: C21.2, C22.2, COUT11.2, COUT12.2, COUT21.2, COUT22.2, CUR1.5 (GND), CUR2.5 (GND), C_41.1, C_42.1, C_CUR11.1, C_CUR12.1, C_CUR21.2, C_CUR22.2, C_IN1.2, C_IN2.2, DOUT1.2 (A), DOUT2.2 (A), MPPT1.2 (GND), MPPT2.2 (GND), R21.1, R22.1, SC1.2 (-), SC2.2 (-); also elsewhere on the board
unnamed: C21.1, MPPT1.5 (VCTRL), R11.1, R21.2
unnamed: C22.1, MPPT2.5 (VCTRL), R12.1, R22.2
unnamed: CF1.1, MPPT1.6 (ICTRL_MINUS), RF21.2
unnamed: CF1.2, MPPT1.7 (ICTRL_PLUS), RF11.2
unnamed: CF2.1, MPPT2.6 (ICTRL_MINUS), RF22.2
unnamed: CF2.2, MPPT2.7 (ICTRL_PLUS), RF12.2
unnamed: C_41.2, MPPT1.1 (MPP-SET), MPPT1.8 (XSHUT), R31.1
unnamed: C_42.2, MPPT2.1 (MPP-SET), MPPT2.8 (XSHUT), R32.1

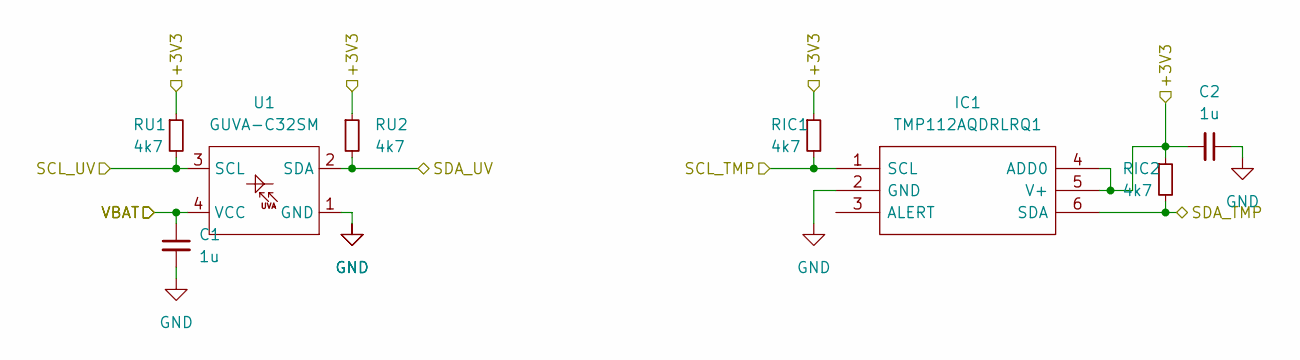
[picture p37: schematic Sensors.kicad_sch]

Parts:
C1, C2: 1u; C_0603_1608Metric
IC1: TMP112AQDRLRQ1; SOTFL50P160X60-6N; Mouser Part Number 595-TMP112AQDRLRQ1
RIC1, RIC2: 4k7; R_0603_1608Metric
RU1, RU2: 4k7; R_0603_1608Metric
U1: GUVA-C32SM; OLGA 2mm x 2,3mm

Connections:
/+3V3: C2.2, IC1.4 (ADD0), IC1.5 (V+), RIC1.1, RIC2.1, RU1.1, RU2.1; also elsewhere on the board
/SCL: IC1.1 (SCL), RIC1.2, RU1.2, U1.3 (SCL); also elsewhere on the board
/SDA: IC1.6 (SDA), RIC2.2, RU2.2, U1.2 (SDA); also elsewhere on the board
/Sensors/VBAT: C1.1, U1.4 (VCC)
GND: C1.2, C2.1, IC1.2 (GND), U1.1 (GND); also elsewhere on the board
