SpaceTeam/STS1_PCB_SIDEPANEL/Muster/STS1_SIDEPANEL.kicad_pcb

## KiCad design Muster/STS1_SIDEPANEL.kicad_pcb (continued)

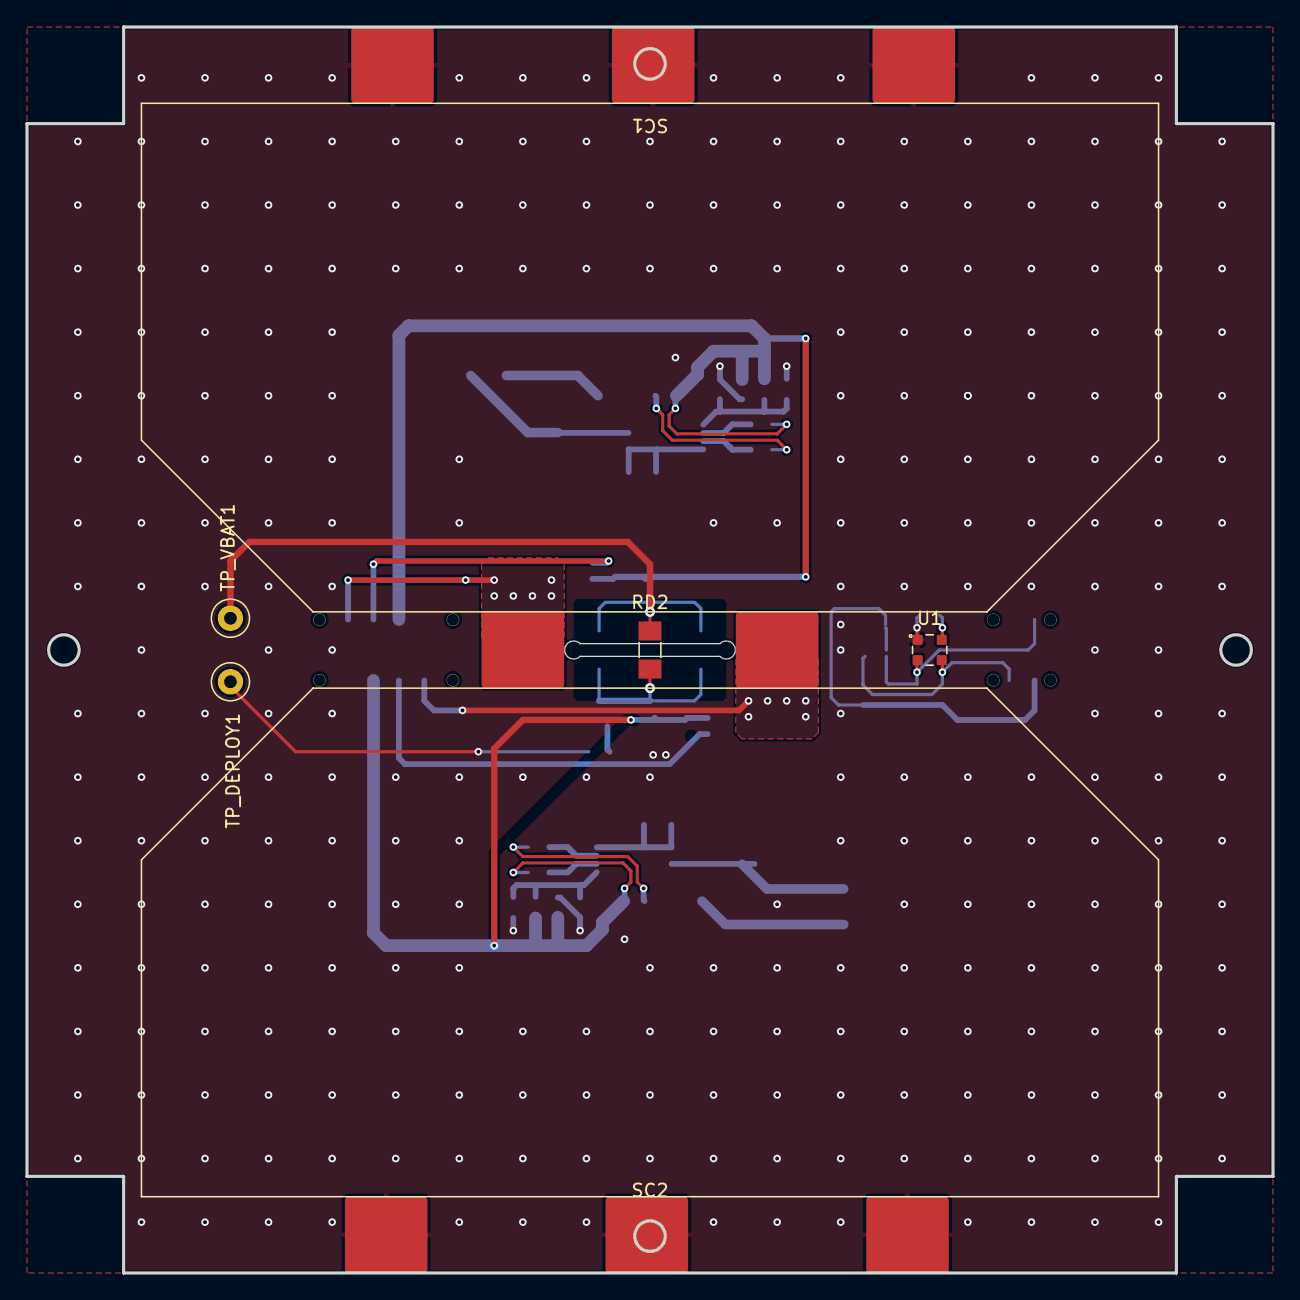
[picture p38: board Muster/STS1_SIDEPANEL.kicad_pcb from above]

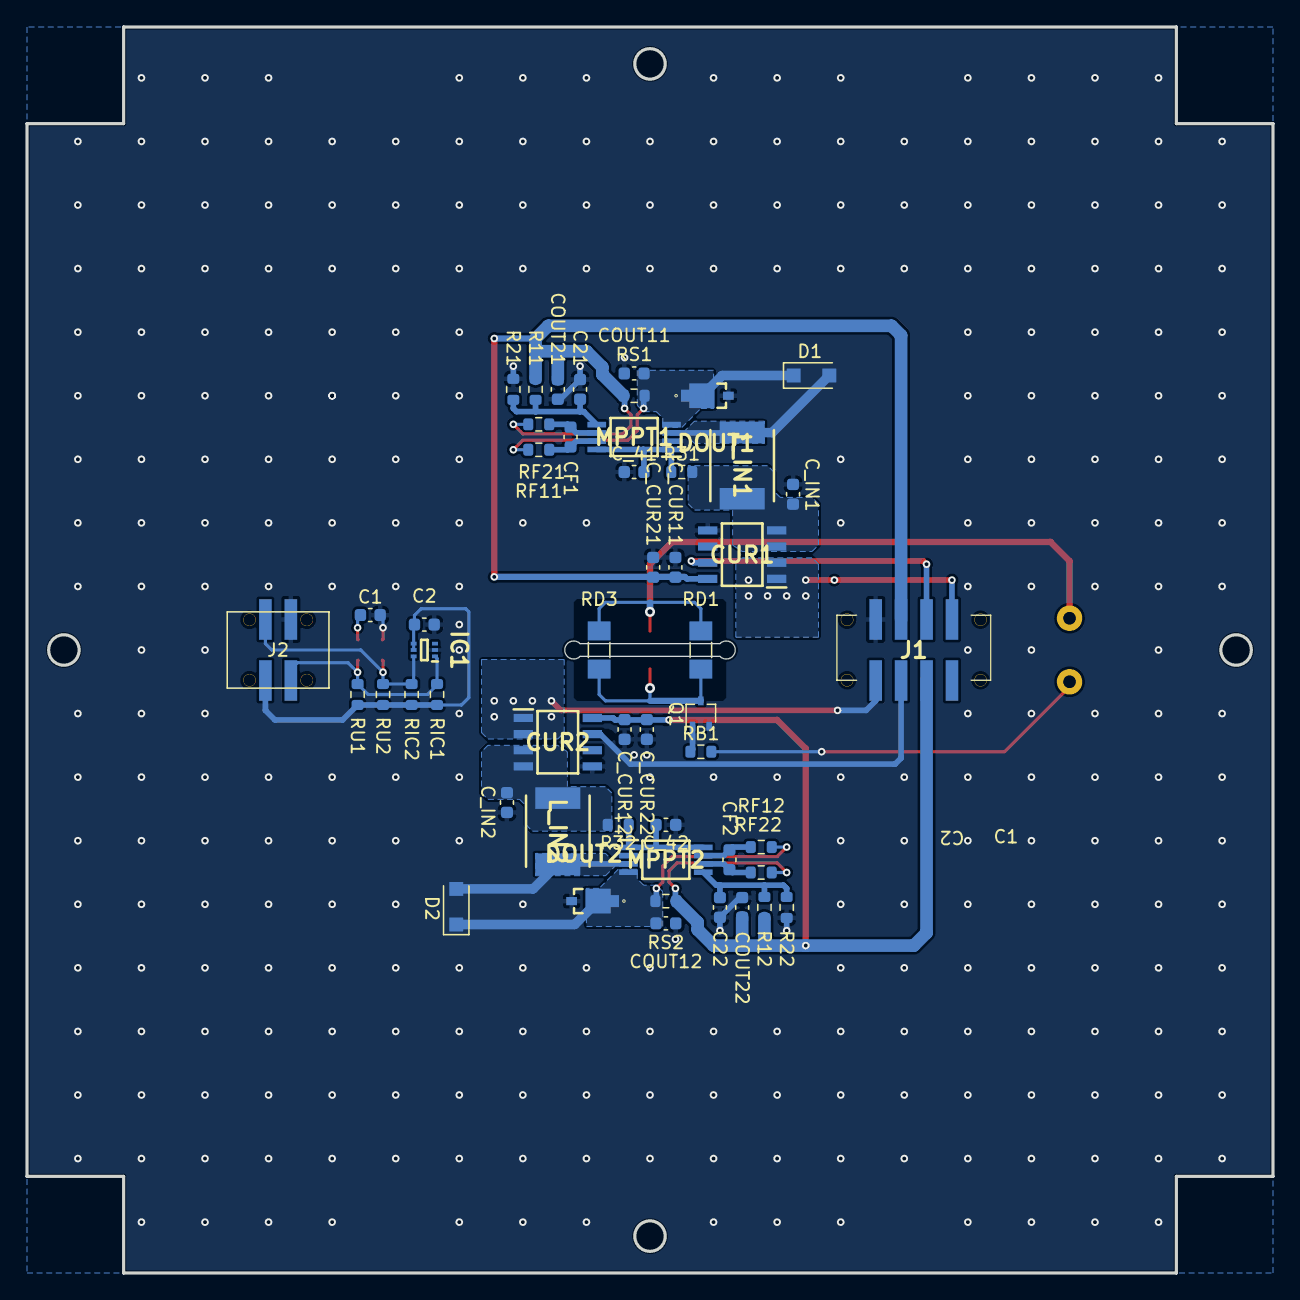
[picture p39: board Muster/STS1_SIDEPANEL.kicad_pcb from below]

Board: 2 copper layers, 98.0 x 98.0 mm, 58 parts (51 on the bottom side), 29 nets.
