SpaceTeam/STS1_PCB_SIDEPANEL/(commit log)

2022-07-06 Side Panels
    [595D_A-case.stp, 595D_B-case.stp, 595D_C-case.stp, 595D_D-case.stp, 595D_G-case.stp, 595D_M-case.stp, 595D_R-case-corrected.stp, 595D_R-case.stp]
2022-07-31 Review Ready for V2.0
    [AntennaDeployment.kicad_sch, CS03_V3_XP.STEP, CS05_V3_XM.STEP, STS1_SIDEPANEL.kicad_pcb, STS1_SIDEPANEL.kicad_sch, STS1_SIDEPANEL_Xm.step, STS1_SIDEPANEL_Xp.step, STS1_SIDEPANEL_Y.step]
2022-08-01 Paar Fehler behoben, Z+ no MOSFET
    [AntennaDeployment.kicad_sch, STS1_SIDEPANEL.kicad_pcb, STS1_SIDEPANEL.kicad_sch, Sensors.kicad_sch, SolarMPPT.kicad_sch]
2022-08-02 Further fixes, still some open
    [STS1_SIDEPANEL.kicad_pcb, STS1_SIDEPANEL.kicad_sch, Sensors.kicad_sch, SolarMPPT.kicad_sch]
2022-08-05 Next fix
    [AntennaDeployment.kicad_sch, STS1_SIDEPANEL.kicad_pcb, STS1_SIDEPANEL.kicad_sch, STS1_SIDEPANEL_Y.step, STS1_SIDEPANEL_all.xlsx, Sensors.kicad_sch, SolarMPPT.kicad_sch]
2022-08-09 release_2.0, Ordered PCBs
    [CS03_V3_XP.STEP, CS05_V3_XM.STEP, STS1_SIDEPANEL.kicad_pcb, STS1_SIDEPANEL.kicad_sch, STS1_SIDEPANEL_Xm.step, STS1_SIDEPANEL_Xp.step, STS1_SIDEPANEL_Y.step, STS1_SIDEPANEL_Zm.step]
2023-04-11 Diode D1 angebracht
    [STS1_SIDEPANEL.kicad_pcb, STS1_SIDEPANEL.kicad_sch, Sensors.kicad_sch, SolarMPPT.kicad_sch]
2023-04-29 Renamed the Sidepanel folders (X- to Y-, X+ to Y+, Y to X)
    [AntennaDeployment.kicad_sch, STS1_SIDEPANEL.kicad_pcb, STS1_SIDEPANEL.kicad_sch, STS1_SIDEPANEL_Y.step, Sensors.kicad_sch, SolarMPPT.kicad_sch]
2023-07-08 changed the outline of the pcbs + new axis orientaion + changed the footprint of the solar cells
    [AntennaDeployment.kicad_sch, STS1_SIDEPANEL.kicad_pcb, STS1_SIDEPANEL.kicad_sch, STS1_SIDEPANEL_Y.step, Sensors.kicad_sch, SolarMPPT.kicad_sch]
2023-07-27 Fixed some DRC errors.
    [STS1_SIDEPANEL.kicad_pcb, STS1_SIDEPANEL.kicad_sch, Sensors.kicad_sch, SolarMPPT.kicad_sch]
2023-09-09 Adjusted the panel naming so that it conforms to the coordinate system convention governed by the Cubesat Design Specification.
    [AntennaDeployment.kicad_sch, STS1_SIDEPANEL.kicad_pcb, STS1_SIDEPANEL.kicad_sch, Sensors.kicad_sch, SolarMPPT.kicad_sch]
2023-09-24 Added step files of the panels
    [STS1_SIDEPANEL.kicad_pcb, STS1_SIDEPANEL_X+.step, STS1_SIDEPANEL_X-.step, STS1_SIDEPANEL_Y.step, STS1_SIDEPANEL_Z.step]
2023-09-27 adjusted the cutout for the camera
    [STS1_SIDEPANEL.kicad_pcb, STS1_SIDEPANEL_X+.step]
2023-10-03 changes to the solar cells footprint, added camera mounts
    [AntennaDeployment.kicad_sch, STS1_SIDEPANEL.kicad_pcb, STS1_SIDEPANEL.kicad_sch, STS1_SIDEPANEL_Y.step, Sensors.kicad_sch, SolarMPPT.kicad_sch]
2023-10-04 small changes of the connectors position
    [AntennaDeployment.kicad_sch, STS1_SIDEPANEL.kicad_pcb, STS1_SIDEPANEL.kicad_sch, STS1_SIDEPANEL_Y.step, Sensors.kicad_sch, SolarMPPT.kicad_sch]
2023-10-04 small changes to the connectors position
    [STS1_SIDEPANEL.kicad_pcb]
2023-10-06 small adjustments
    [STS1_SIDEPANEL.kicad_pcb, STS1_SIDEPANEL.kicad_sch, STS1_SIDEPANEL_X+.step, STS1_SIDEPANEL_X-.step, Sensors.kicad_sch, SolarMPPT.kicad_sch]
2023-10-07 updated the step files
    [STS1_SIDEPANEL.kicad_pcb, STS1_SIDEPANELX-.step, STS1_SIDEPANEL_X+.step, STS1_SIDEPANEL_Y.step]
2023-10-09 changes to the solar cell footprint + added alternative current sensing solution
    [STS1_SIDEPANEL.kicad_pcb, STS1_SIDEPANEL.kicad_sch, STS1_SIDEPANELX-.step, STS1_SIDEPANEL_X-.step, SolarMPPT.kicad_sch]
2023-10-12 changed the x+ and x- axis
    [STS1_SIDEPANEL.kicad_pcb, STS1_SIDEPANEL.kicad_sch, Sensors.kicad_sch, SolarMPPT.kicad_sch]
2023-10-14 added the libraries for the specific components
    [STS1_SIDEPANEL.kicad_pcb, STS1_SIDEPANEL.kicad_sch, SolarMPPT.kicad_sch]
2023-10-15 changes to the position of the connectors and some components
    [STS1_SIDEPANEL.kicad_pcb, STS1_SIDEPANEL.kicad_sch]
2023-10-15 selected the Y+ panel for Y
    [AntennaDeployment.kicad_sch, STS1_SIDEPANEL.kicad_pcb, STS1_SIDEPANEL.kicad_sch, Sensors.kicad_sch, SolarMPPT.kicad_sch]
2023-10-16 Adjusted EPS connector on the Z panel, so that it does not stretch over the heater resistors of the antenna release mechanism.
    [STS1_SIDEPANEL.kicad_pcb]
2023-10-16 Adjusted the position of the connector on the X+ and X- panel, so that there is more space to the connectors on the EPS.
    [STS1_SIDEPANEL.kicad_pcb]
2023-10-16 changes in gerber settings
    [STS1_SIDEPANEL.kicad_pcb]
2023-10-17 Renamed Sidepanel Z+ to Sidepanel Z- and removed Step files.
    [AntennaDeployment.kicad_sch, STS1_SIDEPANEL.kicad_pcb, STS1_SIDEPANEL.kicad_sch, Sensors.kicad_sch, SolarMPPT.kicad_sch]
2023-10-26 removed the solder mask for the solar cells, added the dimensions of panels on silkscreen
    [STS1_SIDEPANEL.kicad_pcb, Sensors.kicad_sch]
2023-10-26 changed the naming on the silkscreen from z+ to z-
    [STS1_SIDEPANEL.kicad_pcb]
2023-10-27 removed the solder paste for the solar cells
    [STS1_SIDEPANEL.kicad_pcb]
2023-10-27 moved the dimensions of the panels in the user.1 layer
    [STS1_SIDEPANEL.kicad_pcb]
2023-10-27 moved the dimension back to the silkscreen
    [STS1_SIDEPANEL.kicad_pcb]
2023-11-02 added the F.Mask for the through holes of the solar cells
    [STS1_SIDEPANEL.kicad_pcb]
2023-12-29 the first version of the flex pcb
    [flex_pcb-rounded.kicad_pcb, flex_pcb-rounded.kicad_sch]
2023-12-29 added the flex pcb
    [STS1_SIDEPANEL.kicad_pcb]
2024-01-31 added the flex PCBs for the camera, X+, Z+ and Y+ and rounded some corners of the X+ cutout
    [STS1_SIDEPANEL.kicad_pcb, edu_flex_pcb.kicad_pcb, edu_flex_pcb.kicad_sch, flex_pcb-rounded.kicad_pcb, flex_pcb-rounded.kicad_sch, flex_pcb_X+.kicad_pcb, flex_pcb_X+.kicad_sch, flex_pcb_Z-.kicad_pcb]
2024-02-10 fix for the issues: #19, #18 moved some components from the edge away to avoid collisions with the new structure
    [STS1_SIDEPANEL.kicad_pcb, STS1_SIDEPANEL.kicad_sch, Sensors.kicad_sch]
2024-04-07 added the UCI
    [UCI.kicad_pcb, UCI.kicad_sch]
2024-04-15 Added small modifications to the existing flex PCBs plus the new ones: Y- and X-.
    [edu_flex_pcb.kicad_pcb, edu_flex_pcb.kicad_sch, flex_pcb-rounded.kicad_pcb, flex_pcb_X+.kicad_pcb, flex_pcb_X-.kicad_pcb, flex_pcb_X-.kicad_sch, flex_pcb_Y-.kicad_pcb, flex_pcb_Y-.kicad_sch]
2024-06-04 Changed the layout of all the sidepanel PCBs to mitigate the problems that arised from the bad previous design.
    [AntennaDeployment.kicad_sch, STS1_SIDEPANEL.kicad_pcb, STS1_SIDEPANEL.kicad_sch, Sensors.kicad_sch, SolarMPPT.kicad_sch, UCI.kicad_pcb, UCI.kicad_sch, edu_flex_pcb.kicad_pcb]
2024-06-09 Added a separate ground for the EDU sensors and did some small changes for ordering.
    [STS1_SIDEPANEL.kicad_pcb, STS1_SIDEPANEL.kicad_sch, Sensors.kicad_sch, UCI.kicad_pcb, UCI.kicad_sch]
2024-06-09 Commit before the order.
    [STS1_SIDEPANEL.kicad_pcb, UCI.kicad_pcb, UCI.kicad_sch]
2024-06-12 small changes before the order
    [STS1_SIDEPANEL.kicad_pcb, STS1_SIDEPANEL.kicad_sch]
2024-08-04 Restructure FlexPCB folders, SP_EPS_YP done
    [SP_EPS_YP_Flex.kicad_pcb, SP_EPS_YP_Flex.kicad_sch, edu_flex_pcb.kicad_pcb, edu_flex_pcb.kicad_sch, flex_pcb-rounded.kicad_pcb, flex_pcb-rounded.kicad_sch, flex_pcb_X+.kicad_pcb, flex_pcb_X+.kicad_sch]
2024-08-04 Add SP EPS ZP
    [SP_EPS_ZP_Flex.kicad_pcb, SP_EPS_ZP_Flex.kicad_sch]
2024-08-04 Add SP EPS ZM
    [SP_EPS_ZM_Flex.kicad_pcb, SP_EPS_ZM_Flex.kicad_sch]
2024-08-04 ADD SP EPS YM and XP
    [SP_EPS_XP_Flex.kicad_pcb, SP_EPS_XP_Flex.kicad_sch, SP_EPS_YM_Flex.kicad_pcb, SP_EPS_YM_Flex.kicad_sch]
2024-08-09 moved the connectors, changed the footprint of the input and output capacitors and splitted the input capacitor in two
    [STS1_SIDEPANEL.kicad_pcb, STS1_SIDEPANEL.kicad_sch, SolarMPPT.kicad_sch]
2024-08-11 small change in the routing
    [STS1_SIDEPANEL.kicad_pcb]
2024-08-15 Update the EPS FlexPCBs, with correct top/down and crossed out
    [SP_EPS_XP_Flex.kicad_pcb, SP_EPS_YP_Flex.kicad_pcb, SP_EPS_ZM_Flex.kicad_pcb, SP_EPS_ZP_Flex.kicad_pcb]
2024-08-17 Z+ Cam Connector Rerout & 90deg trace removal
    [STS1_SIDEPANEL.kicad_pcb, STS1_SIDEPANEL.kicad_sch, Sensors.kicad_sch, SolarMPPT.kicad_sch]
2024-08-17 Z- Cam Connerctor Rerout, add vias & 90deg trace removal
    [STS1_SIDEPANEL.kicad_pcb, STS1_SIDEPANEL.kicad_sch, Sensors.kicad_sch, SolarMPPT.kicad_sch]
2024-08-19 Minor improvements. - Added some vias to current carrying traces. - Added edge outline to sidepanel z+ again. - Fixed some minor warnings.
    [STS1_SIDEPANEL.kicad_pcb]
2024-08-20 Add FM Gerber Production files
    [STS1_SIDEPANEL-B_Cu.gbl, STS1_SIDEPANEL-B_Mask.gbs, STS1_SIDEPANEL-B_Paste.gbp, STS1_SIDEPANEL-B_Silkscreen.gbo, STS1_SIDEPANEL-Edge_Cuts.gm1, STS1_SIDEPANEL-F_Cu.gtl, STS1_SIDEPANEL-F_Mask.gts, STS1_SIDEPANEL-F_Paste.gtp]
2024-08-20 Restructure Deliveryfiles
    [STS1_SIDEPANEL-B_Cu.gbl, STS1_SIDEPANEL-B_Mask.gbs, STS1_SIDEPANEL-B_Paste.gbp, STS1_SIDEPANEL-B_Silkscreen.gbo, STS1_SIDEPANEL-Edge_Cuts.gm1, STS1_SIDEPANEL-F_Cu.gtl, STS1_SIDEPANEL-F_Mask.gts, STS1_SIDEPANEL-F_Paste.gtp]
2024-08-21 Current BOM status
    [BOM_STS1_Sidepanels.xlsx]
2024-08-22 Changed the values of the VCTRL resistors.
    [AntennaDeployment.kicad_sch, STS1_SIDEPANEL.kicad_pcb, STS1_SIDEPANEL.kicad_sch, Sensors.kicad_sch, SolarMPPT.kicad_sch]
2024-08-22 Update Dhruva FM order
    [BOM_STS1_Sidepanels.xlsx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]
2024-08-23 Sent Dhruva the BOM_STS1_Sidepanels
    [BOM_STS1_Sidepanels.xlsx]
2024-08-28 Zwischenspeicherung Customs
    [BOM_STS1_Sidepanels.xlsx]
2024-09-02 Updated according to the review from Dhruva.
    [STS1_SIDEPANEL.kicad_pcb]
2024-09-02 Refilled all zones of the PCB.
    [STS1_SIDEPANEL.kicad_pcb]
2024-09-02 Update BOM status and add an invoice
    [BOM_STS1_Sidepanels.xlsx]
2024-09-02 Update to V1.2, fix Mounting holes
    [STS1_SIDEPANEL.kicad_pcb]
2024-09-03 Move final Export docuemnts to the Nextcloud
    [BOM_STS1_Sidepanels.xlsx]
2024-09-07 Update SP_EDU_Cam_ZM_Flex for FM
    [SP_EDU_Cam_ZM_Flex.kicad_pcb, SP_EDU_Cam_ZM_Flex.kicad_sch, edu_flex_pcb.kicad_pcb]
2024-09-07 Update SP_EDU_Z_Flex for FM
    [SP_EDU_Cam_Z_Flex.kicad_pcb, SP_EDU_Cam_Z_Flex.kicad_sch, SP_EDU_Z_Flex.kicad_pcb, SP_EDU_Z_Flex.kicad_sch, flex_pcb_X+.kicad_pcb, flex_pcb_X+.kicad_sch, flex_pcb_Y-.kicad_pcb, flex_pcb_Y-.kicad_sch]
2024-09-07 Update SP_EDU_Flex_TopDown for FM
    [SP_EDU_Cam_Z_Flex_TopDown.kicad_pcb, SP_EDU_Cam_Z_Flex_TopDown.kicad_sch, SP_EDU_Z_Flex_TopDown.kicad_pcb, SP_EDU_Z_Flex_TopDown.kicad_sch]
2024-09-08 Update SP_EDU_YP_Flex for FM
    [SP_EDU_Cam_Z_Flex.kicad_pcb, SP_EDU_Cam_Z_Flex_TopDown.kicad_pcb, SP_EDU_YP_Flex.kicad_pcb, SP_EDU_YP_Flex.kicad_sch, SP_EDU_Z_Flex.kicad_pcb, SP_EDU_Z_Flex.kicad_sch, SP_EDU_Z_Flex_TopDown.kicad_pcb, SP_EPS_XP_Flex.kicad_pcb]
2024-09-08 Update SP_EDU_YM_Flex for FM
    [SP_EDU_YM_Flex.kicad_pcb, SP_EDU_YM_Flex.kicad_sch]
2024-10-12 changed all vias from blind to trough and removed the unused pins of the uci connector
    [STS1_SIDEPANEL.kicad_pcb, UCI.kicad_pcb, UCI.kicad_sch]
2024-10-12 removed the unused pins also from the PCB
    [UCI.kicad_pcb]
2024-10-12 chaned the connectors for the cameras from buttom to top contact
    [STS1_SIDEPANEL.kicad_pcb, STS1_SIDEPANEL.kicad_sch]
2024-10-13 connected the vias for the solar cell together
    [STS1_SIDEPANEL.kicad_pcb]
2024-10-15 moved the camera connectors to be sure that the cable can be inserted
    [STS1_SIDEPANEL.kicad_pcb]
2024-10-15 Removed some unnecessary drawings from the silkscreen.
    [STS1_SIDEPANEL.kicad_pcb]
2024-10-15 Generated the gerber files and moved some vias around.
    [STS1_SIDEPANEL.kicad_pcb]
2024-10-27 Changed one of the inputs capacitors for all panels with one of 1 uF and lower ESR and moved some traces that were under the inductor.
    [STS1_SIDEPANEL.kicad_pcb, SolarMPPT.kicad_sch]
2024-11-09 generated the gerber files for ordering
    [STS1_SIDEPANEL.kicad_pcb]
2025-01-20 update of the files for JLC order
    [STS1_SIDEPANEL.kicad_pcb, UCI.kicad_pcb]
2026-07-18 replace ZF5S-*-01-T-WT and 2005280040 connectors with T1M-*-F-SH-L-FR connector
2026-07-31 mirror the pinout of the connector on the Z- panel, split output capacitor in two capacitors
2026-10-17 change connector for antenna deployment
